danieltyukov/tue-bep/SIITME/Bump modeling.pptx

## TU/e huisstijl

Wednesday, 10 September 2025

- Timo Matray

- IC group, Department of Electrical Engineering

## Bump model

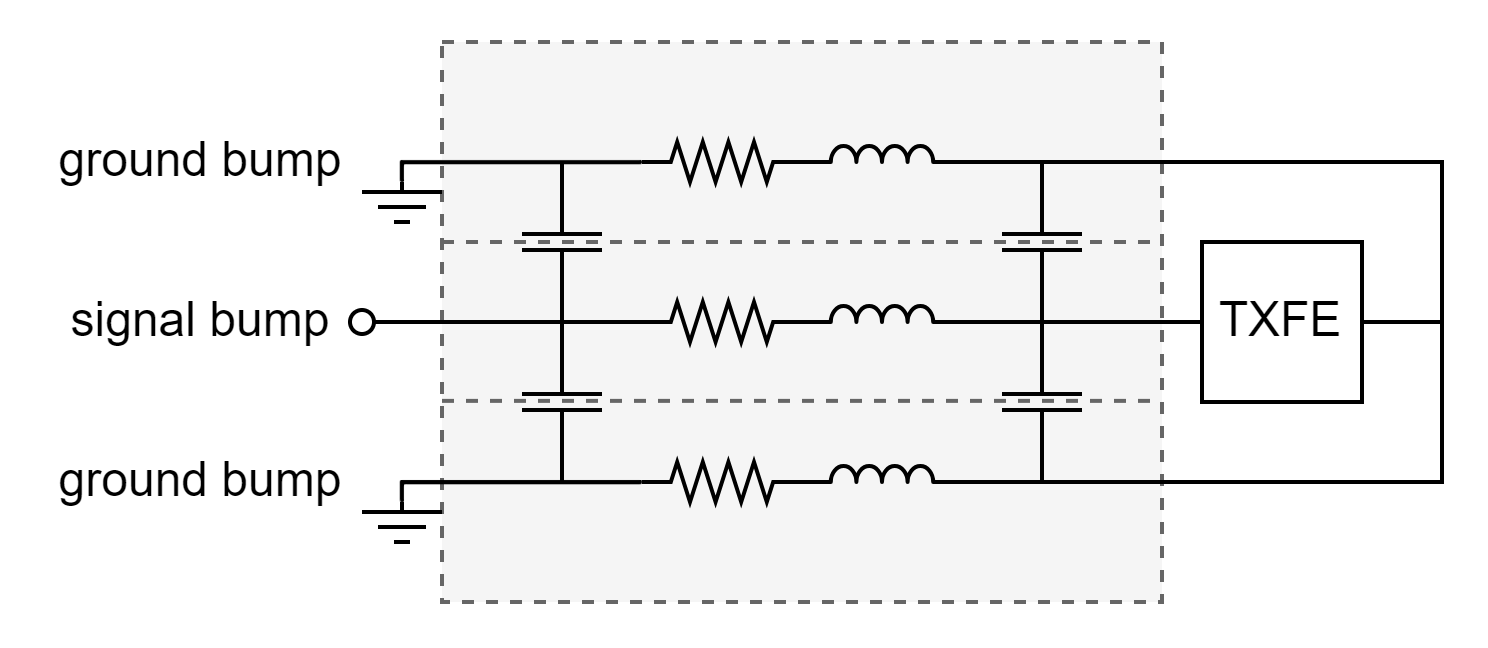
[picture p16: figure]

Timo Matray

## Slide 3

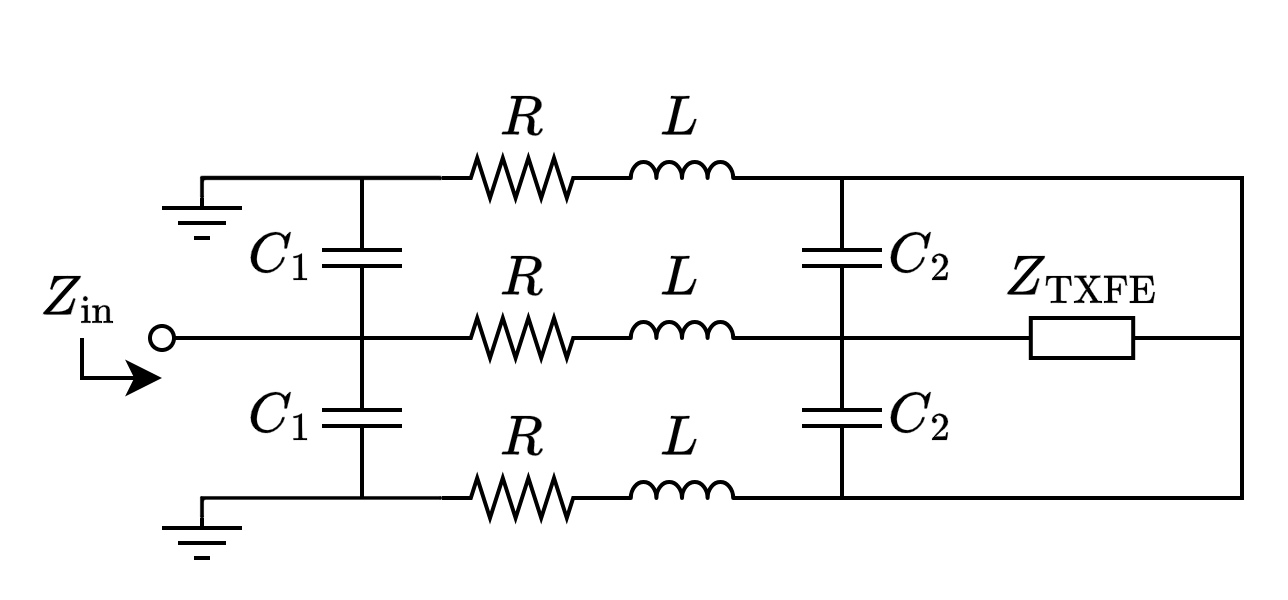
[picture p17: figure]

## Parallel ground paths

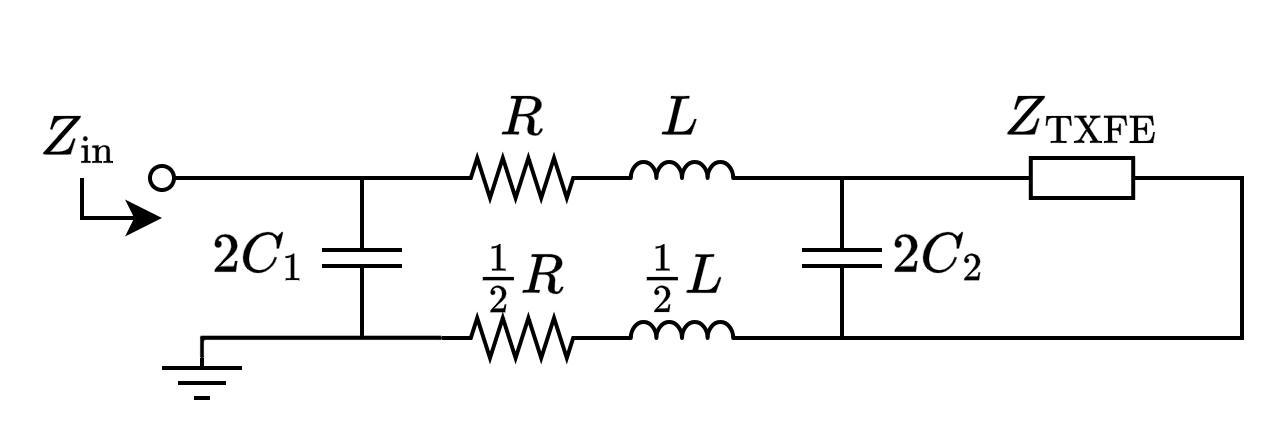
[picture p18: figure]

## RCL

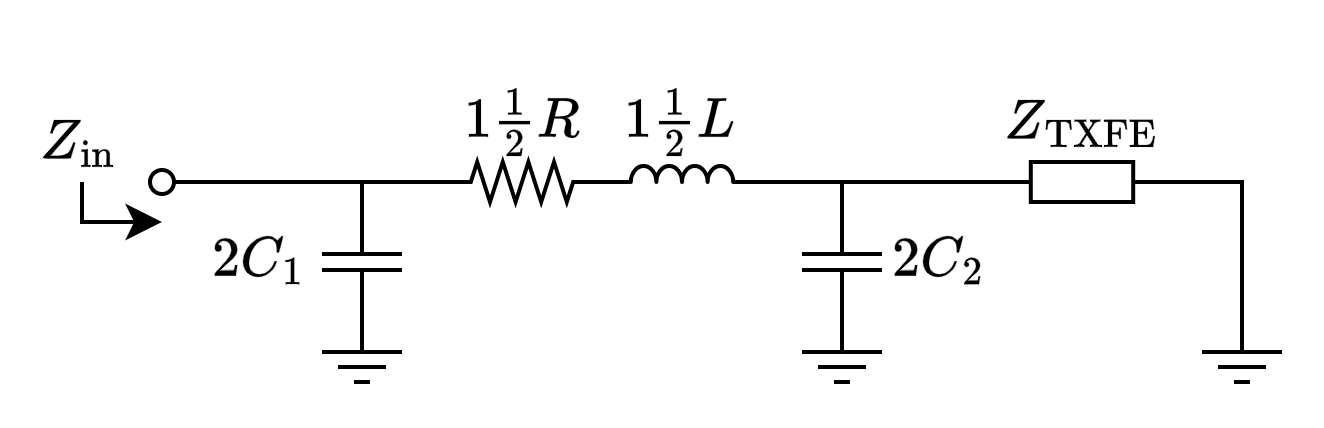
[picture p19: figure]

## Impedance fitting

## CRL

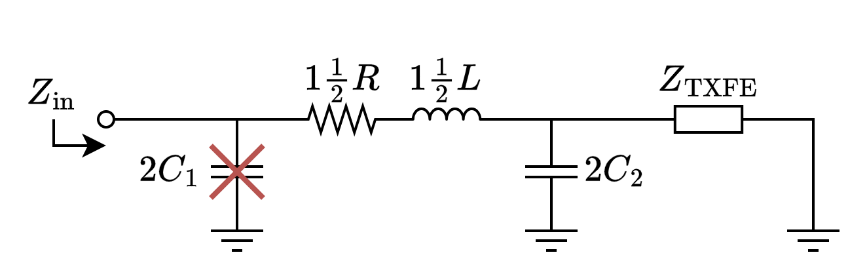
[picture p20: figure]

- R = 3.45 Ohm
- L = 218 nH
- C2 = 1.04 pF

## CRLC

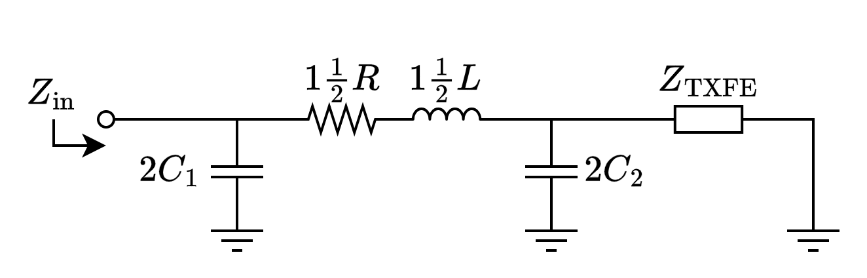
[picture p21: figure]

- C1 = 295 fF
- R = 3.45 Ohm
- L = 179 pH
- C2 = -1.22 pF

## CRL

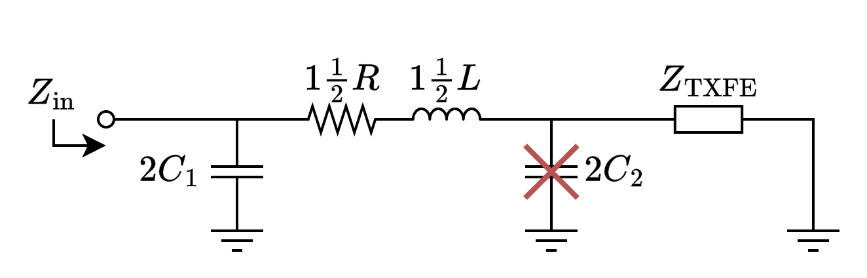
[picture p22: figure]

- C1 = 261 fF
- R = 3.45 Ohm
- L = 158 pH

## CRL (R not fixed)

- C1 = 185 fF
- R = 5.53 Ohm
- L = 201 pH

## CRL

- C1 = 261 fF
- R = 3.45 Ohm
- L = 158 pH
- ez,rel,max = 8.70 Ohm (30.6%)
- @ 6.02 GHz
- ez,abs,max = 10.3 Ohm (17.8%)
- @ 10.0 GHz
- ez,abs = 8.80 Ohm
- @ 6.23 GHz & 9.89 GHz

## S11 fitting

## CRL (R not fixed)

- S11

C1 = 185 fF
R = 5.16 Ohm
L = 211 pH

- Impedance

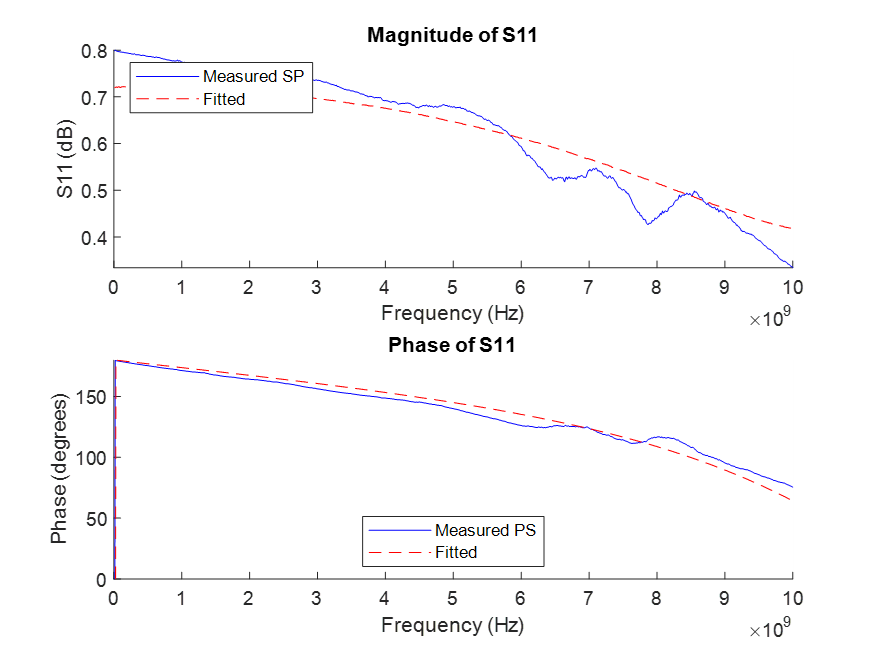
[picture p23: figure]
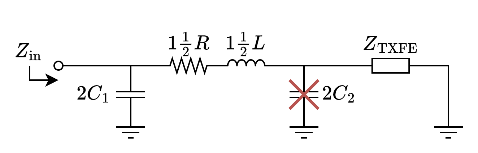
[picture p24: figure]

## CRL

- S11

C1 = 249 fF
R = 3.45 Ohm
L = 178 pH

- Impedance

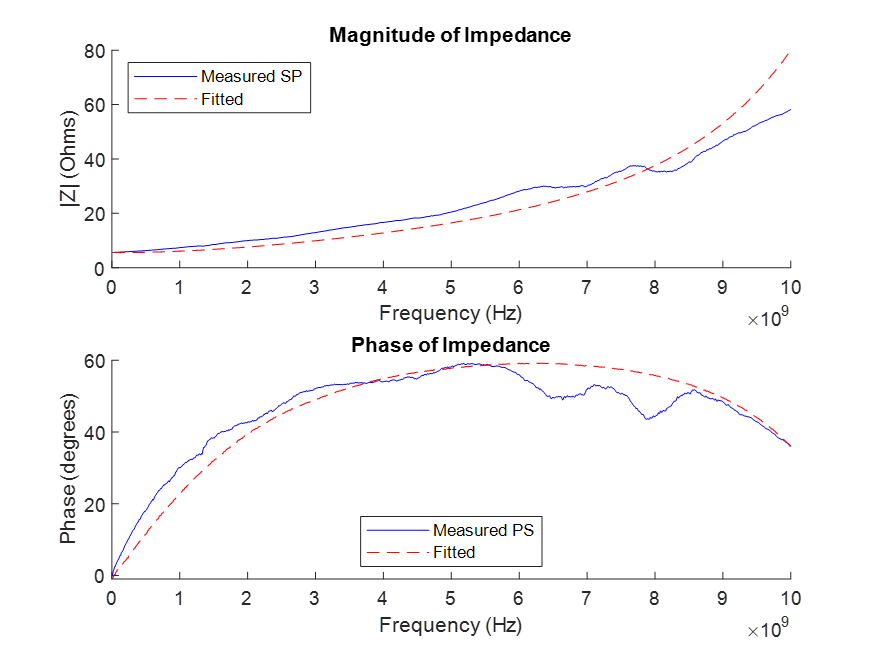
[picture p25: figure]
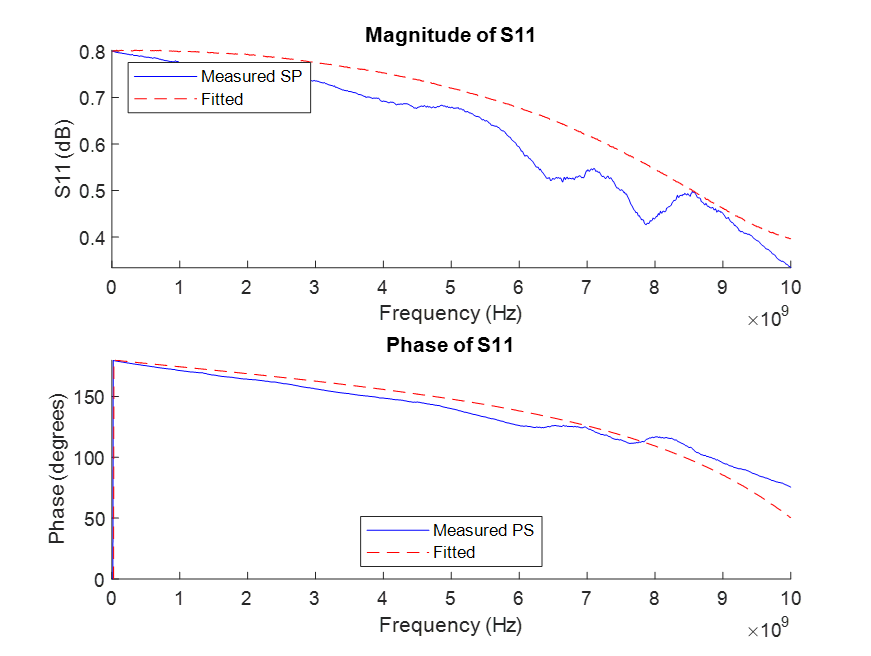
[picture p26: figure]

## CRL (optimized up to 5 GHz)

- S11

C1 = 249 fF
R = 3.45 Ohm
L = 178 pH

- Impedance
