danieltyukov/tue-bep/rf_die/Bonding Diagram RXFE 1 copy.pdf

# TXFE

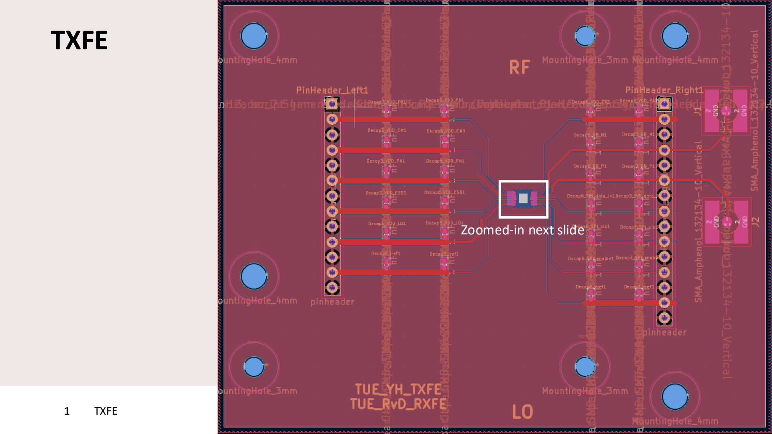
[picture p49: page 1]

1 TXFE

Zoomed-in next slide

# TXFE

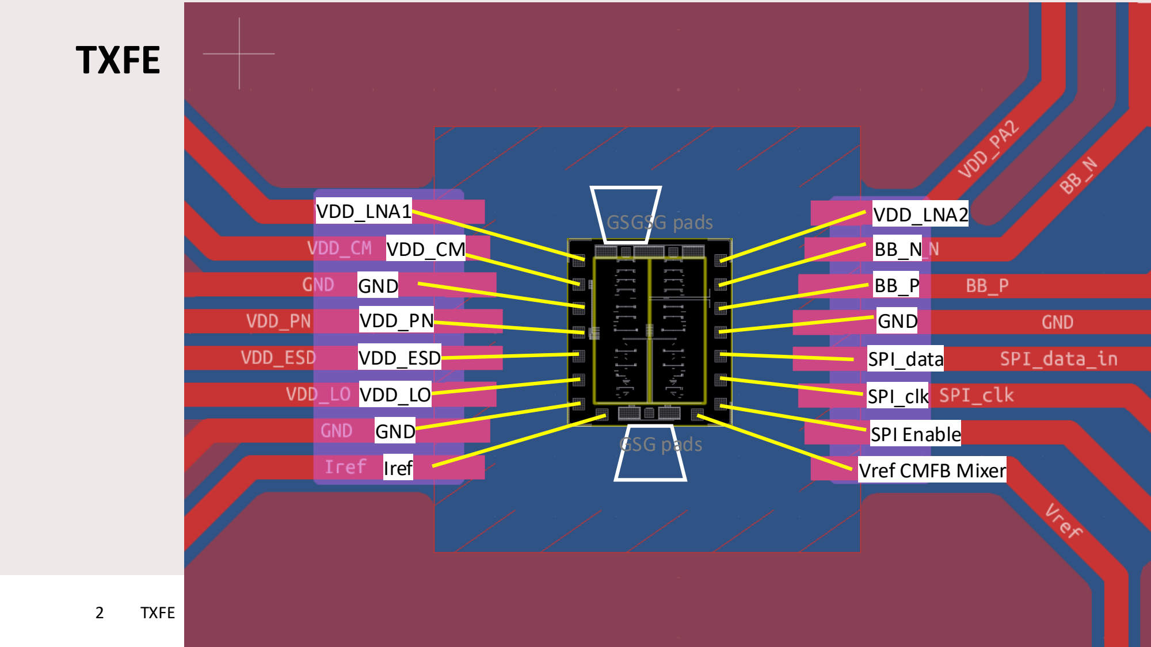
[picture p50: page 2]

TXFE

2

GSGSG pads

GSG pads
Vref CMFB Mixer

SPI Enable

SPI_clk

SPI_data

GND

BB_P

BB_N

VDD_LNA2

Iref

VDD_PN

VDD_LO

VDD_ESD

VDD_LNA1

GND

VDD_CM

GND
