danieltyukov/tue-bep/markdown_notes_and_files/litrature-preliminary/prior bep presentation.pdf

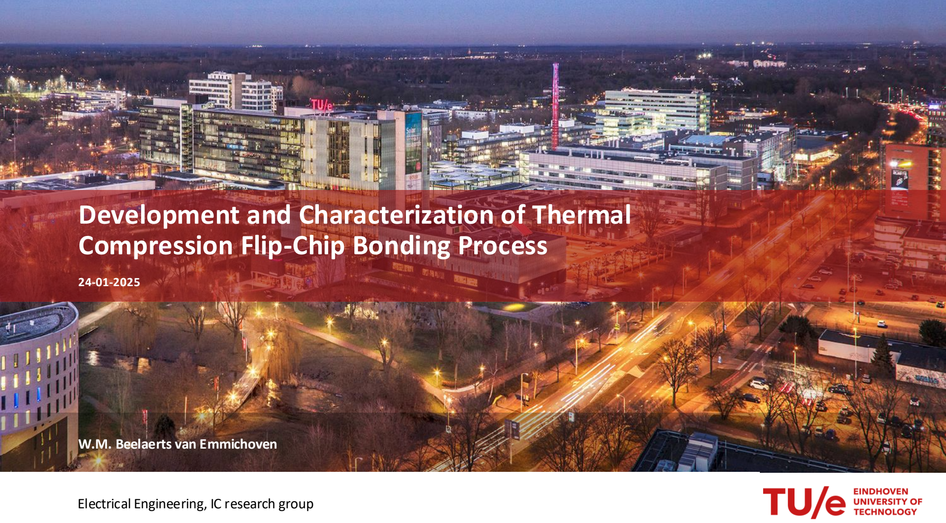
[picture p57: page 1]

# Development and Characterization of Thermal Compression Flip-Chip Bonding Process

24-01-2025

W.M. Beelaerts van Emmichoven

Electrical Engineering, IC research group

# Applications of the project

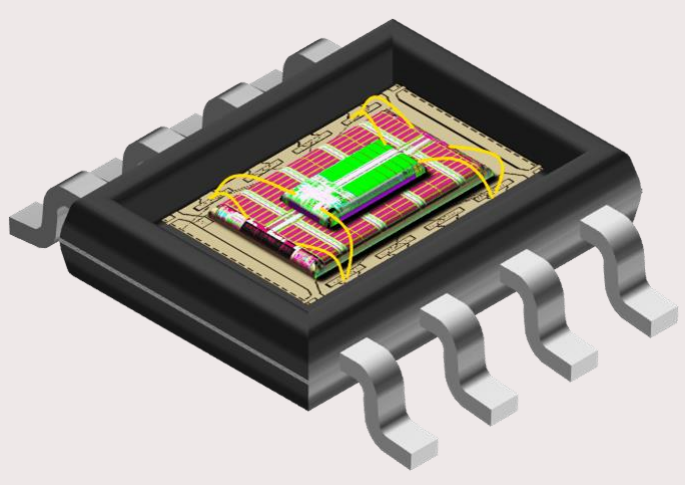
[picture p58: figure]

## - High-tech applications

## - Speed increasingly important - Hardware limitations

## - More and faster connections required

## - Packaging

2 Process Development and Characterization of Thermal Compression Flip-Chip Bonding

# Purpose of the project

## - Flip-Chip Technology vs Wire Bonding

### - More interconnections - Shorter interconnections - Lower propagation time

## - Process existence benefits TU/e projects requiring FCT

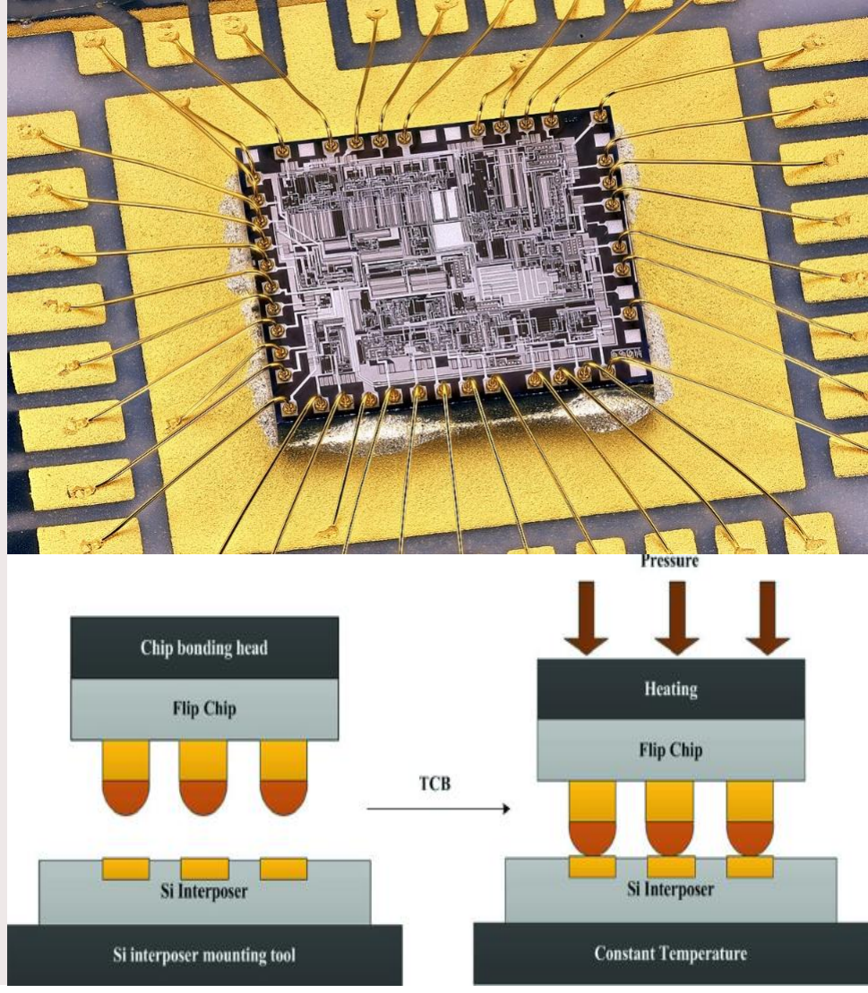
[picture p59: figure]

3 Process Development and Characterization of Thermal Compression Flip-Chip Bonding

# Project setup

## - Proposed process: 4 stages

### - Interposer design & production - Bump placement - Die placement - Testing

## - Developed for IC group

### - Cleanroom - Electronics lab

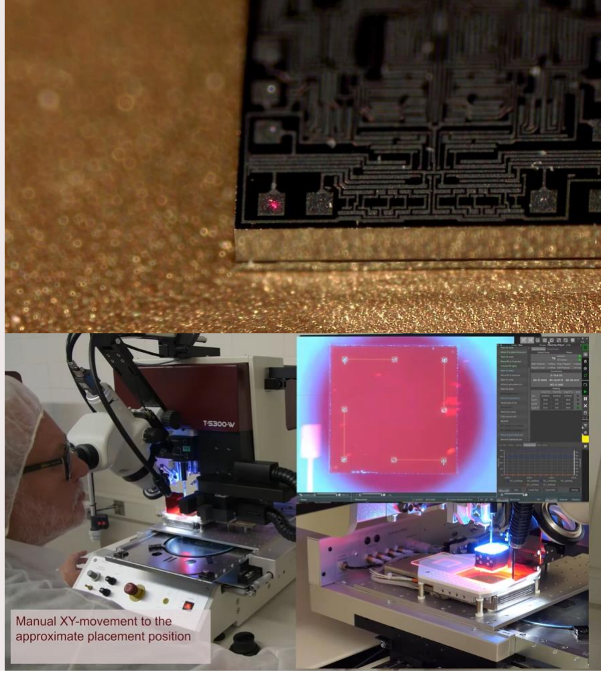
[picture p60: figure]

4 Process Development and Characterization of Thermal Compression Flip-Chip Bonding

# Process developments: Interposer Design

## - Glass interposer

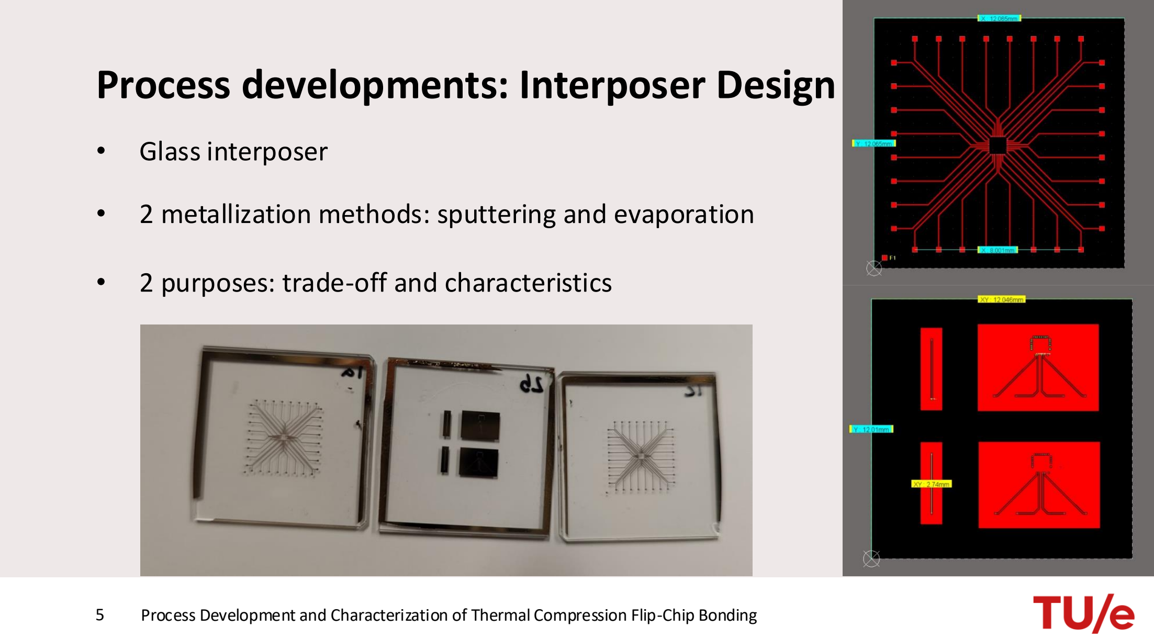
[picture p61: page 5]

## - 2 metallization methods: sputtering and evaporation

## - 2 purposes: trade-off and characteristics

5 Process Development and Characterization of Thermal Compression Flip-Chip Bonding

# Process developments: Interposer Characterization

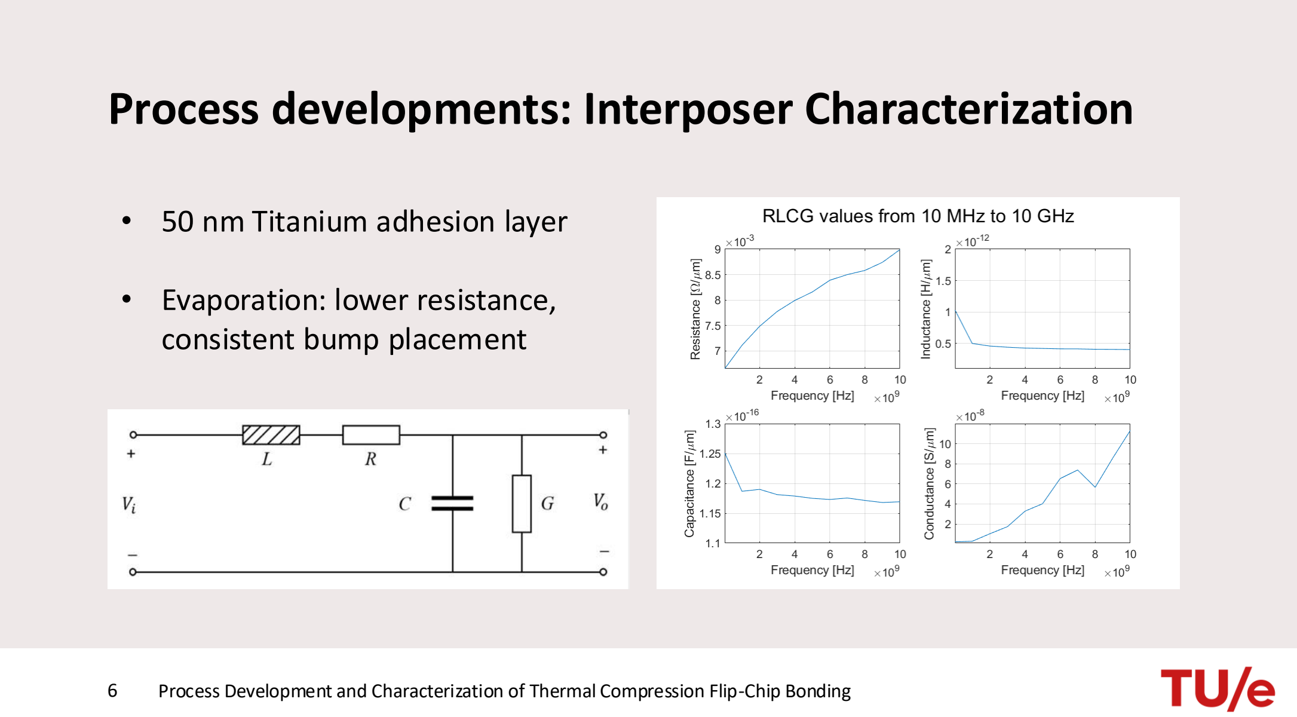
[picture p62: page 6]

6 Process Development and Characterization of Thermal Compression Flip-Chip Bonding

## - 50 nm Titanium adhesion layer

- Evaporation: lower resistance,

## consistent bump placement

# Process developments: Bumps

## - 25 vs 17 um gold wire

### - Good bump quality on small gold surface areas, but bad on large areas - Reliable process - Requires pad pitch > 90 um

## - Placement method: cursor as reference

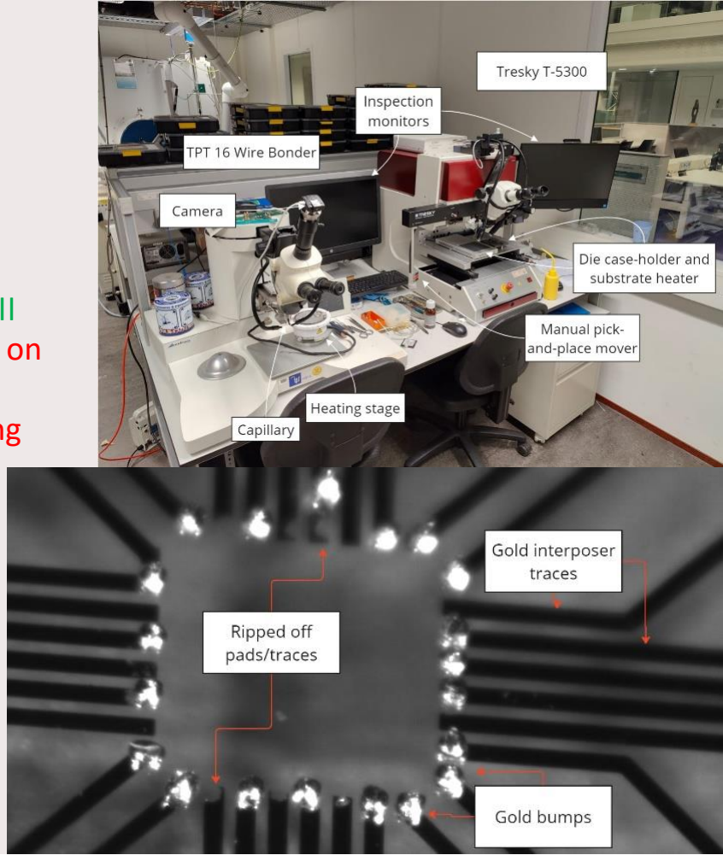
[picture p63: figure]

7 Process Development and Characterization of Thermal Compression Flip-Chip Bonding

### - Good bump quality on small gold surface areas, but bad on large areas - Unreliable process - clogging - 90 um pad pitch works

# Process developments: Dies

## - Heat profile, force and duration settings required

## - Semi-successful attempt

## - Weight distribution

## - Metal connections confirmed

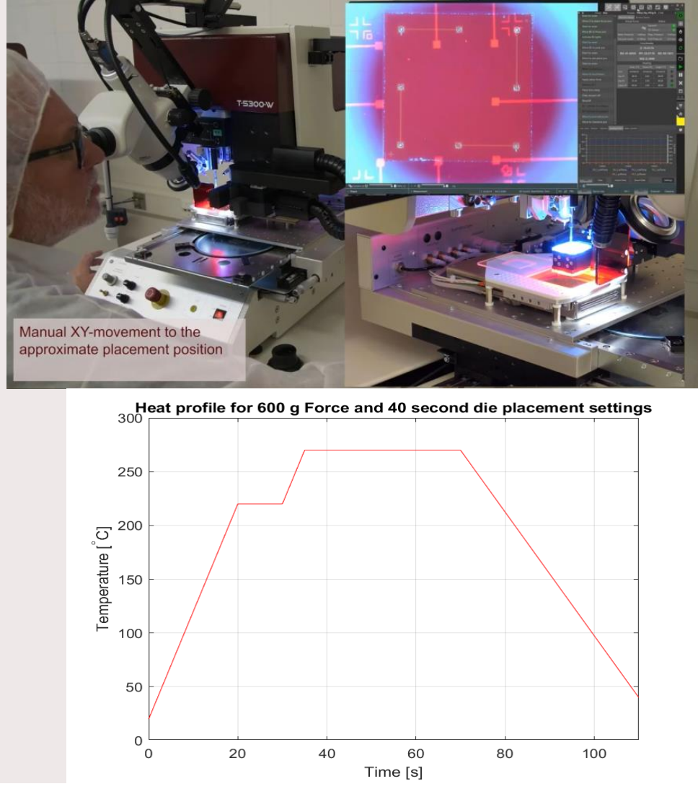
[picture p64: figure]

8 Process Development and Characterization of Thermal Compression Flip-Chip Bonding

# Final remarks

## - Cooperation with Accelonix recommended

## - Evaporation preferred production method

## - 25 um gold wire process most reliable, but requires pad pitch size > 90 um

## - Future research steps:

## 1. Improving and optimizing settings for bump and die placement 2. Investigate AC behaviour of tracks at frequencies >> 10 GHz 3. Exploring electrical characteristics of the bumps

9 Process Development and Characterization of Thermal Compression Flip-Chip Bonding

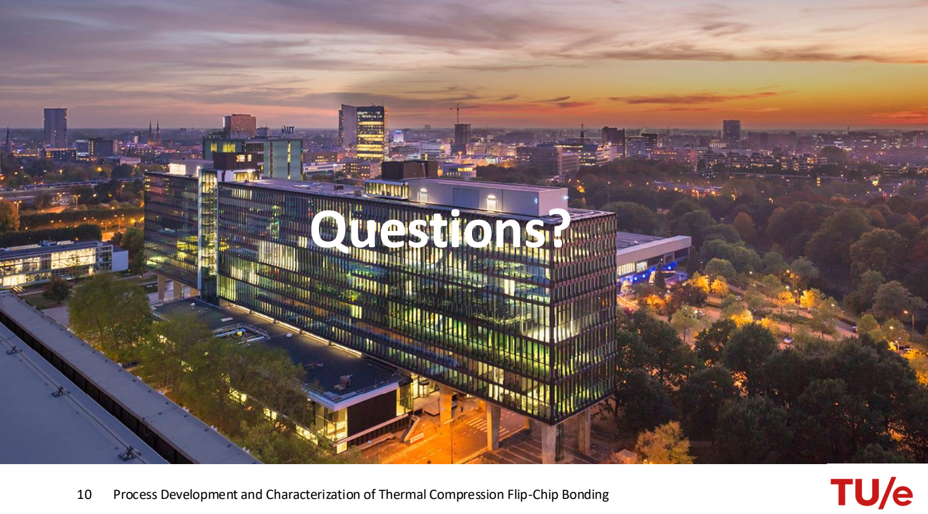
[picture p65: page 10]

10 Process Development and Characterization of Thermal Compression Flip-Chip Bonding

# Questions?
