danieltyukov/tue-bep/rf_die/interposer_estimates_v1.pdf

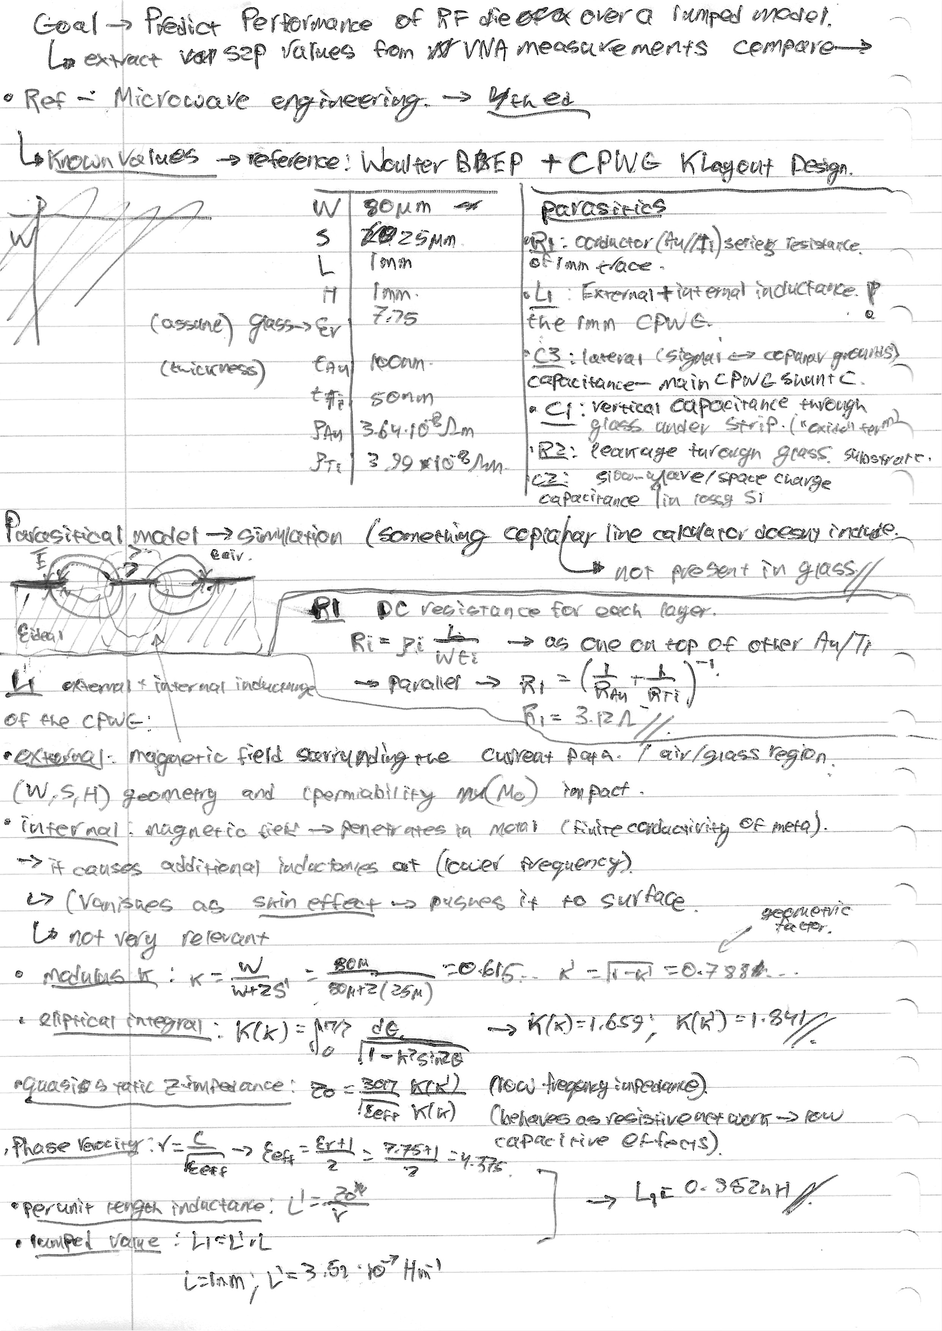
[picture p90: page 1]
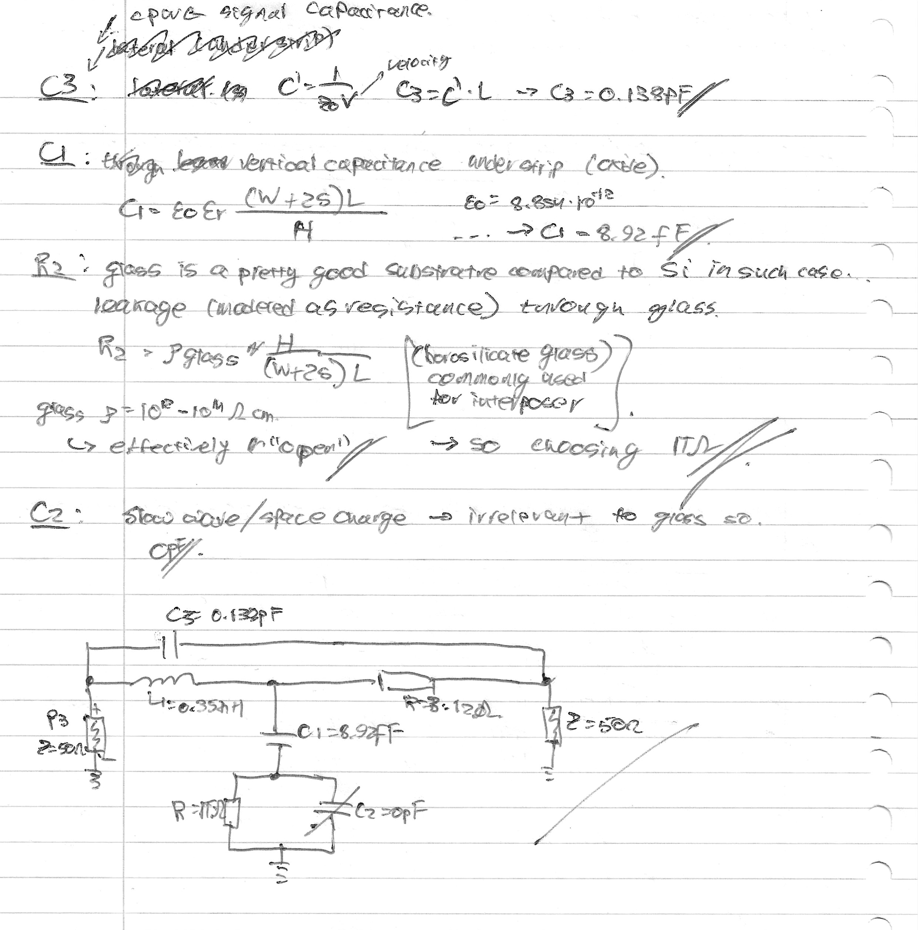
[picture p91: page 2]
