danieltyukov/tue-bep/SIITME/SIITME_2025_v1/figures/flipchip2.pdf

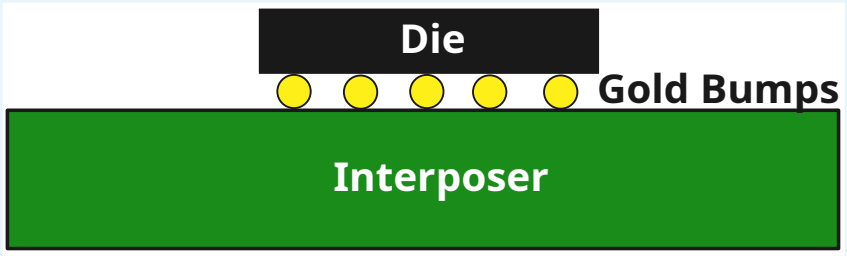
[picture p92: figure]
Interposer; Die; Gold Bumps
