danieltyukov/tue-bep/amplifier_die/inverted-tgf-amplifier-mask.png

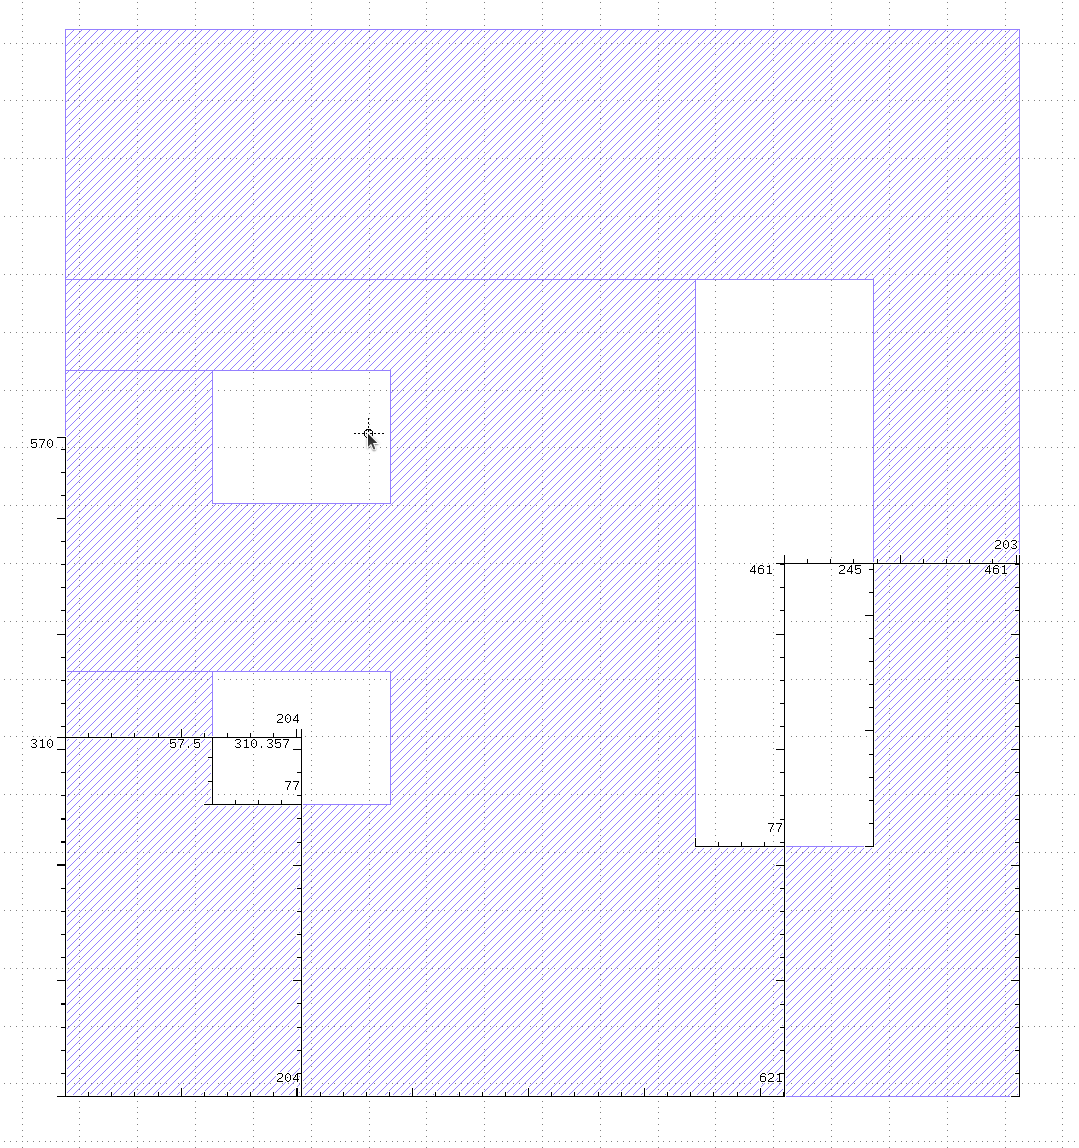
amplifier_die/inverted-tgf-amplifier-mask.png
