danieltyukov/tue-bep/amplifier_die/smd-0603-0402.jpg

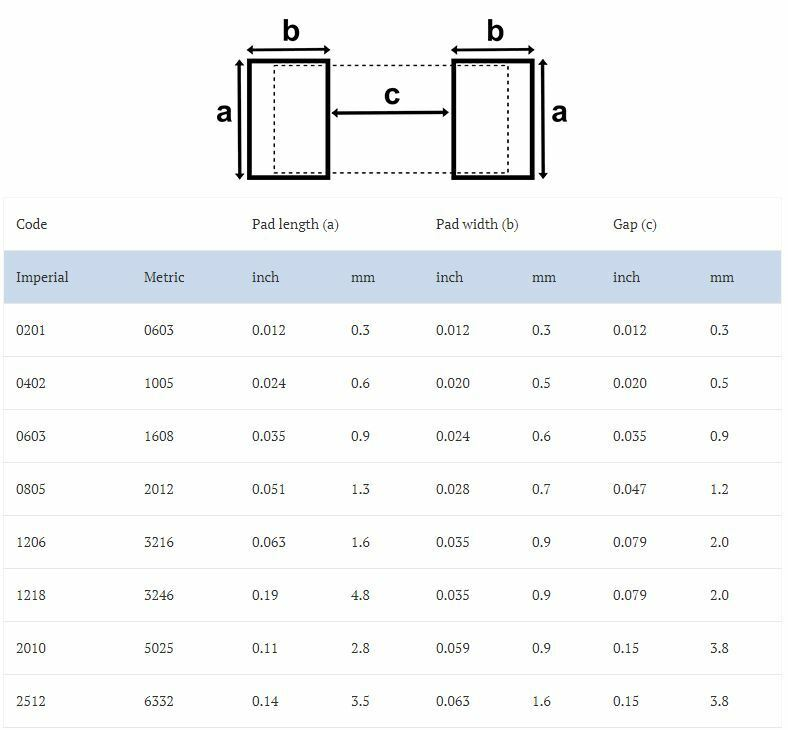
amplifier_die/smd-0603-0402.jpg
