danieltyukov/tue-bep/final_pics_for_paper/tgf_2023_2_02_cw_model_circuit_qucs.png

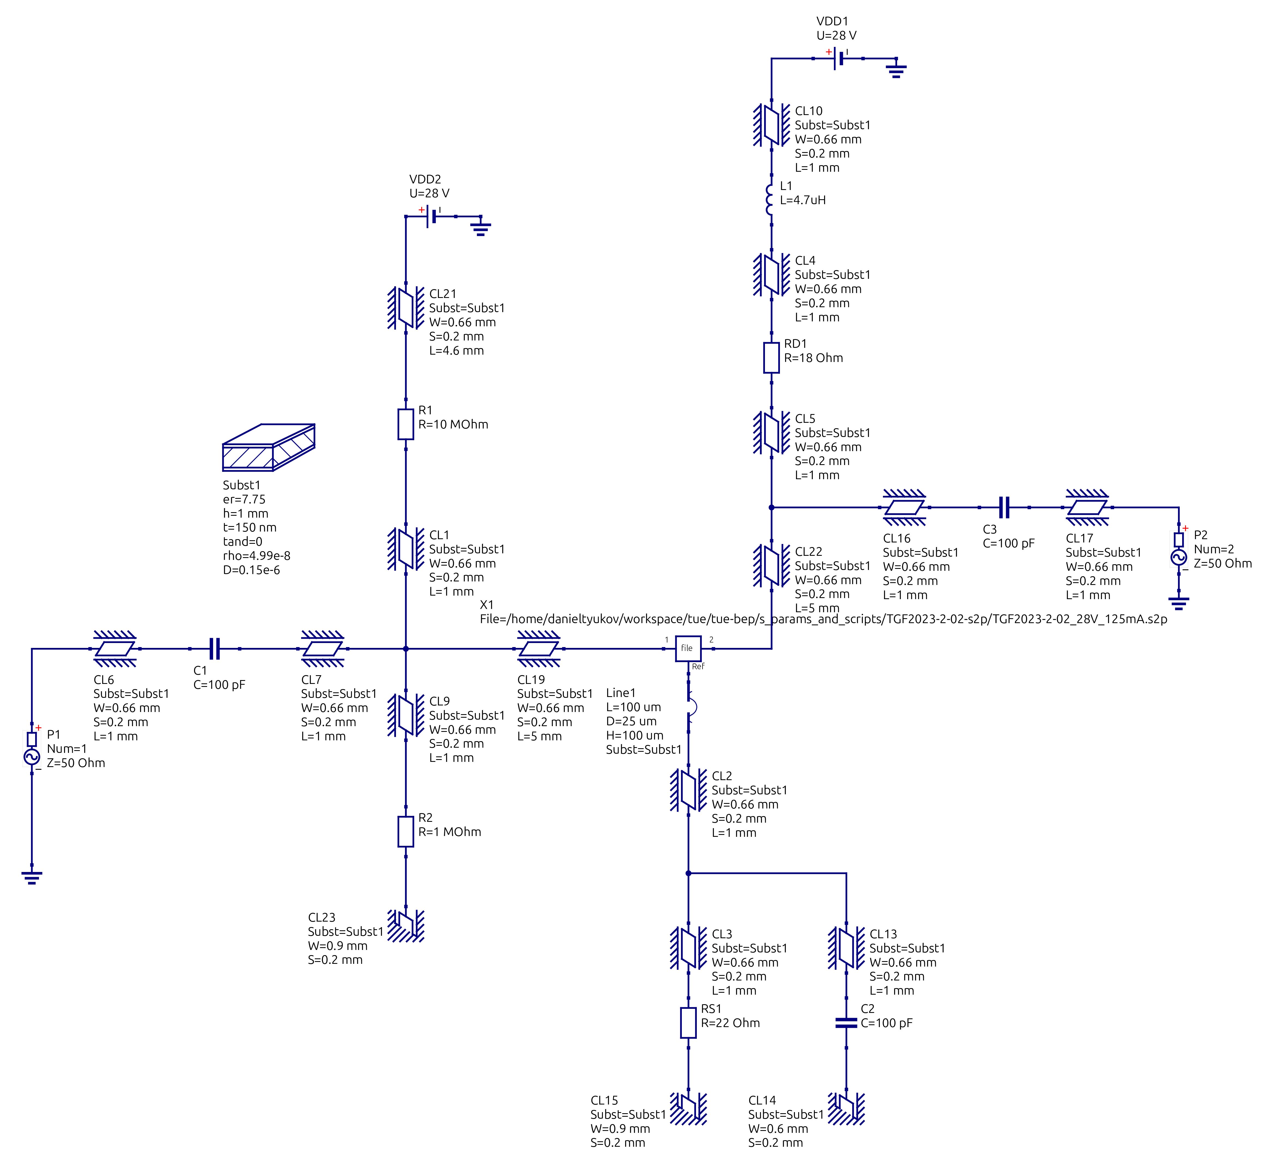
final_pics_for_paper/tgf_2023_2_02_cw_model_circuit_qucs.png
