danieltyukov/tue-bep/rf_die/dbS33.png

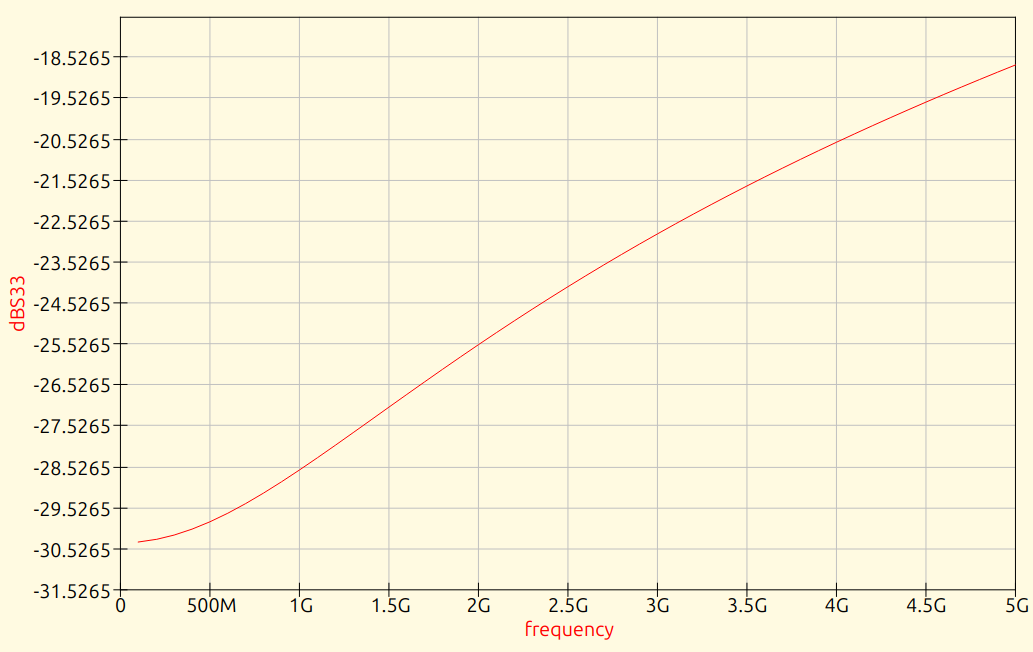
rf_die/dbS33.png
