danieltyukov/tue-bep/rf_die/dbS43.png

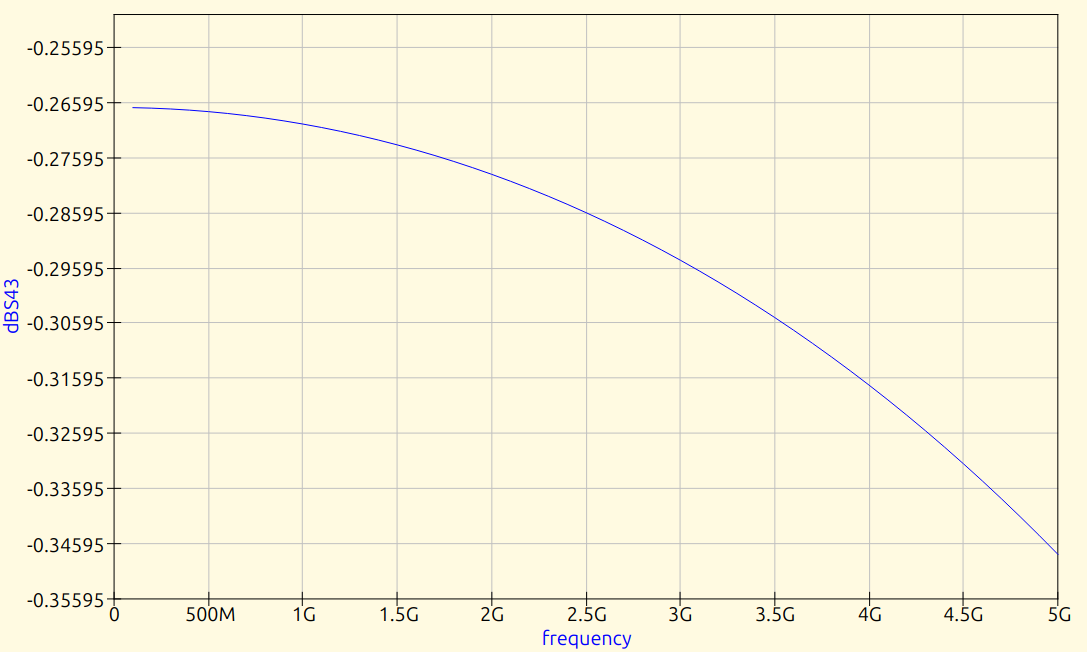
rf_die/dbS43.png
