danieltyukov/tue-bep/rf_die/qucs_cwg_calcs/external_pads_150um.png

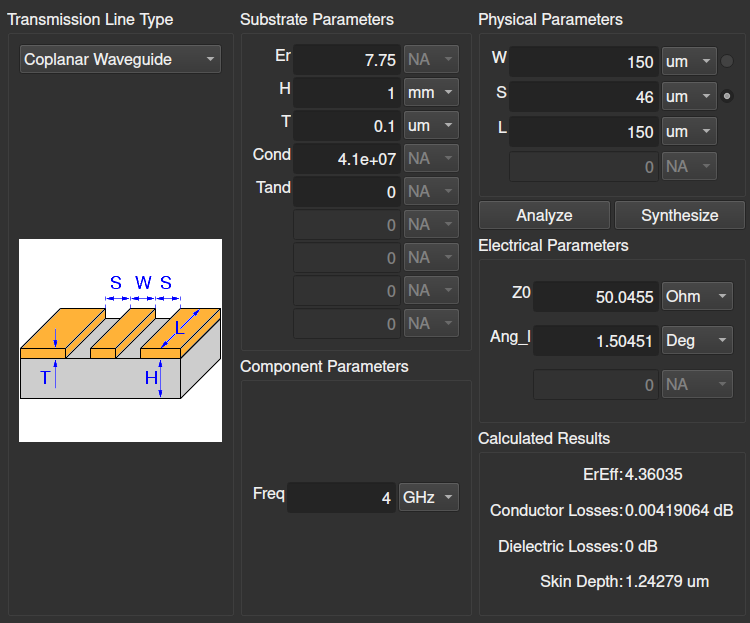
rf_die/qucs_cwg_calcs/external_pads_150um.png
