danieltyukov/tue-bep/rf_die/qucs_cwg_calcs/gsg/traces_60um_unrealistic.png

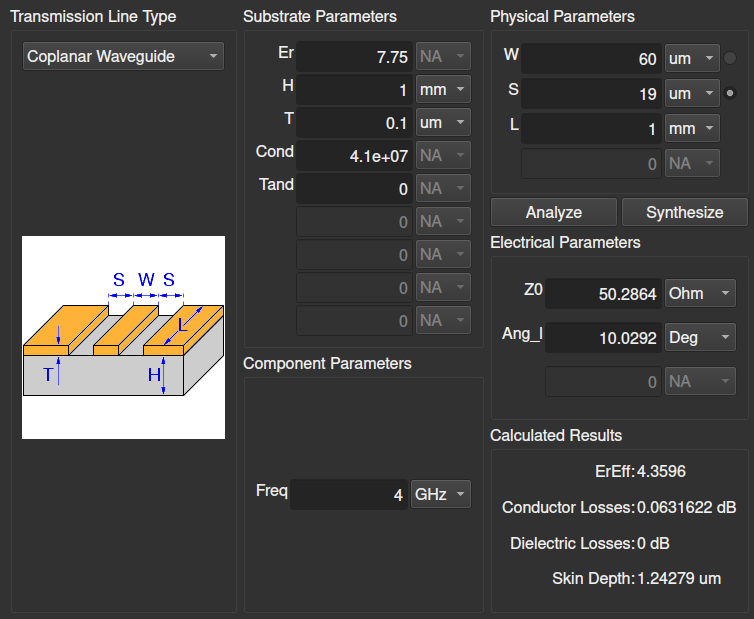
rf_die/qucs_cwg_calcs/gsg/traces_60um_unrealistic.png
