danieltyukov/tue-bep/rf_die/rf chip dimensions.png

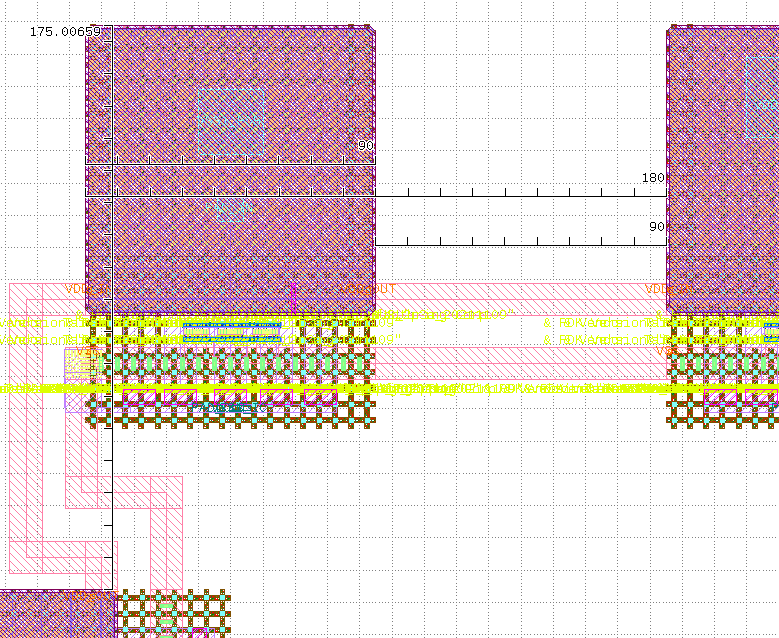
rf_die/rf chip dimensions.png
