danieltyukov/tue-bep/SIITME/SIITME_2025_v1/figures/ball width.png

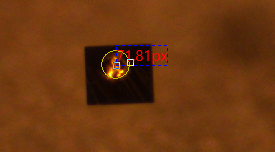
SIITME/SIITME_2025_v1/figures/ball width.png
