danieltyukov/tue-bep/SIITME/SIITME_2025_v1/figures/die.jpeg

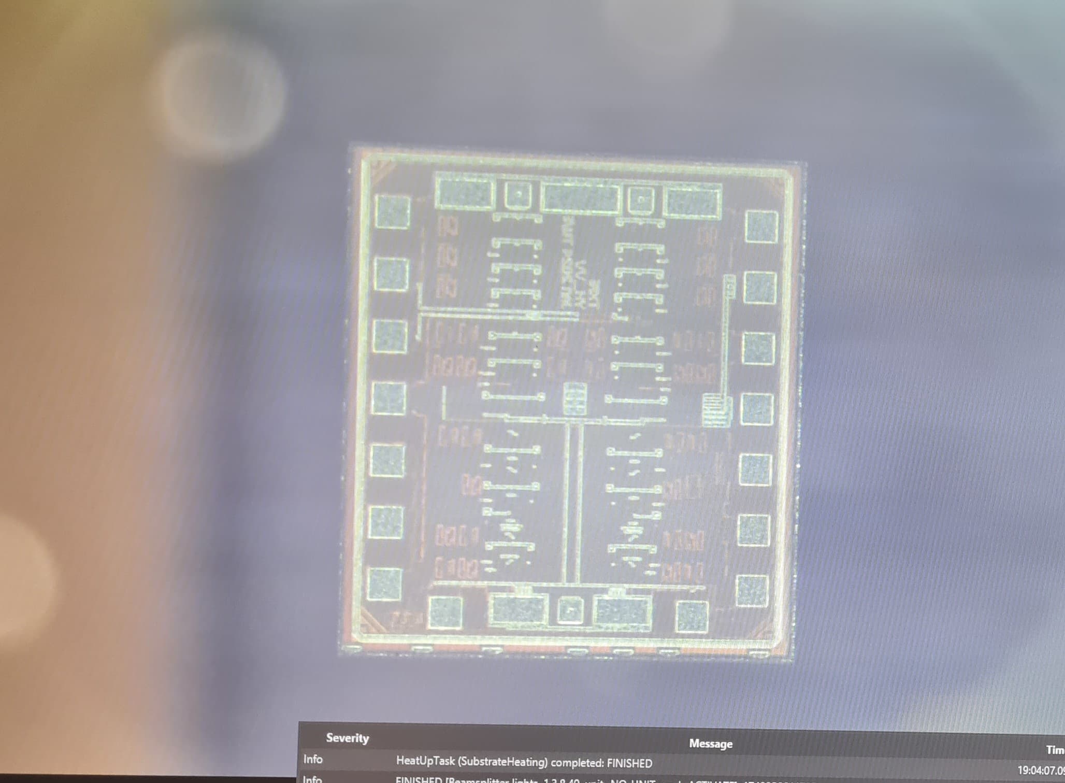
SIITME/SIITME_2025_v1/figures/die.jpeg
