danieltyukov/tue-bep/SIITME/SIITME_2025_v1/figures/flip_chipped_fake_die.jpeg

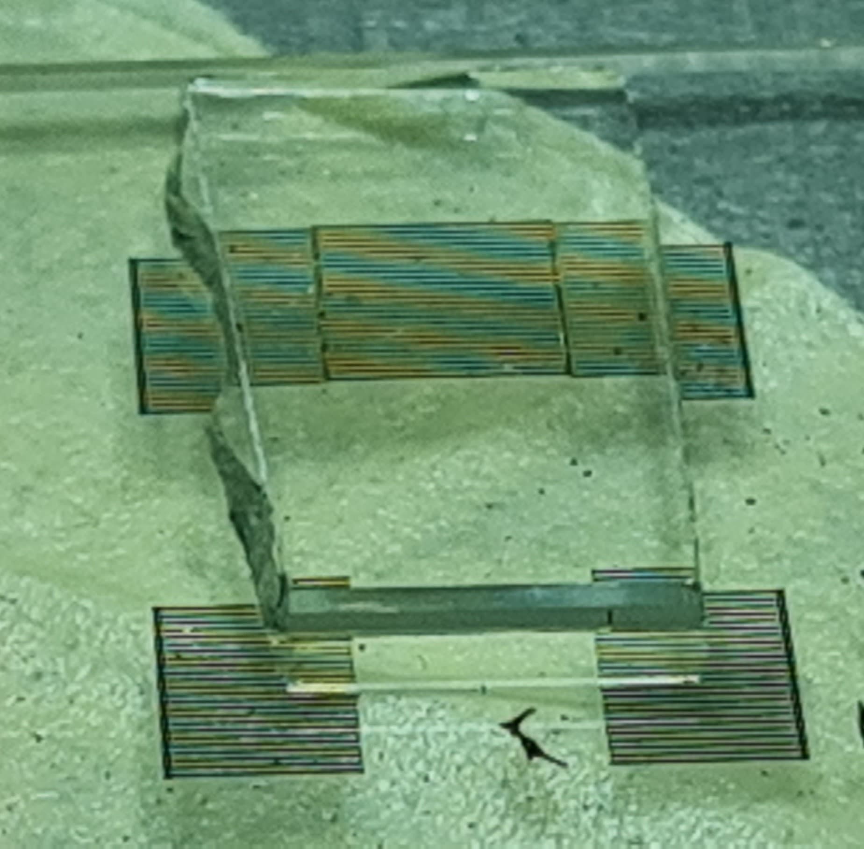
SIITME/SIITME_2025_v1/figures/flip_chipped_fake_die.jpeg
