danieltyukov/tue-bep/SIITME/SIITME_2025_v1/figures/goldbump_thermalprofile1.jpeg

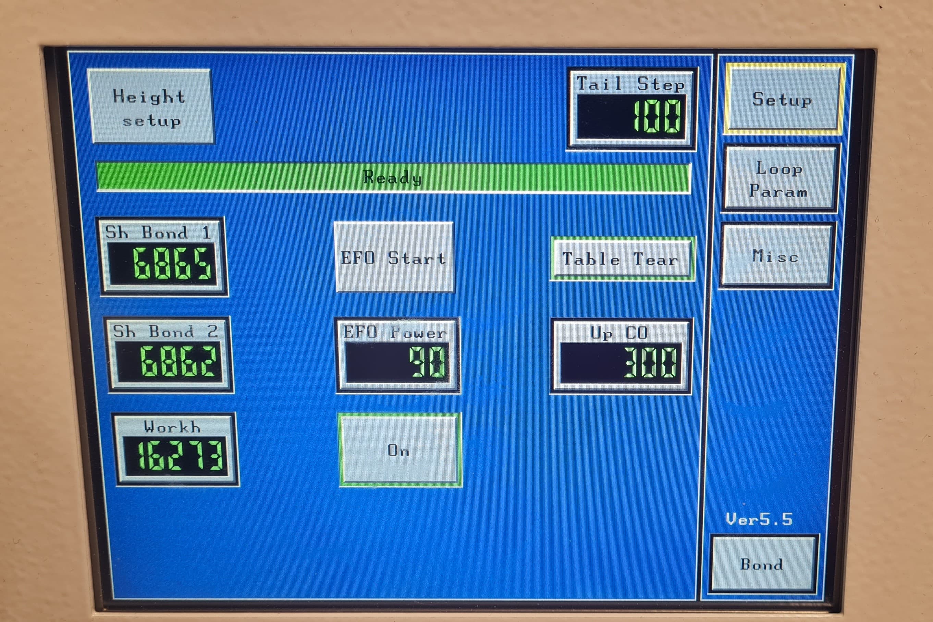
SIITME/SIITME_2025_v1/figures/goldbump_thermalprofile1.jpeg
