danieltyukov/tue-bep/SIITME/SIITME_2025_v1/figures/goldbump_thermalprofile2.jpeg

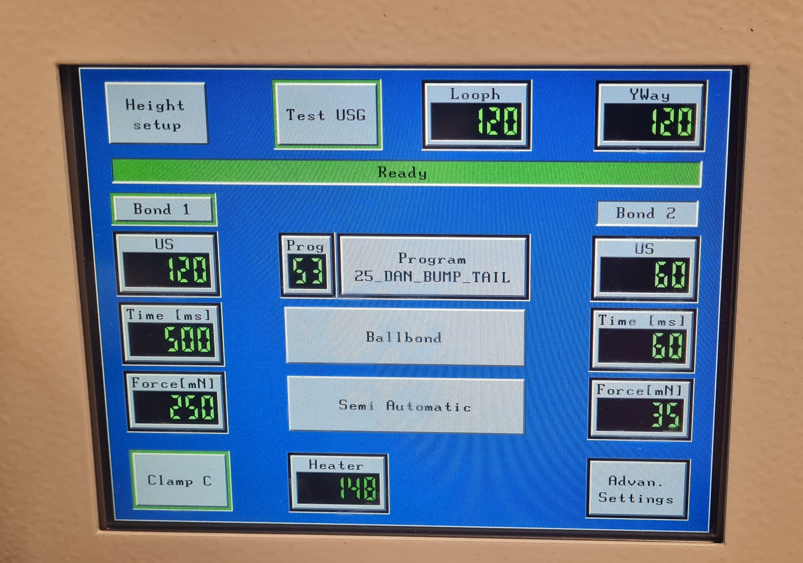
SIITME/SIITME_2025_v1/figures/goldbump_thermalprofile2.jpeg
