danieltyukov/tue-bep/SIITME/SIITME_2025_v1/figures/goldbumps.png

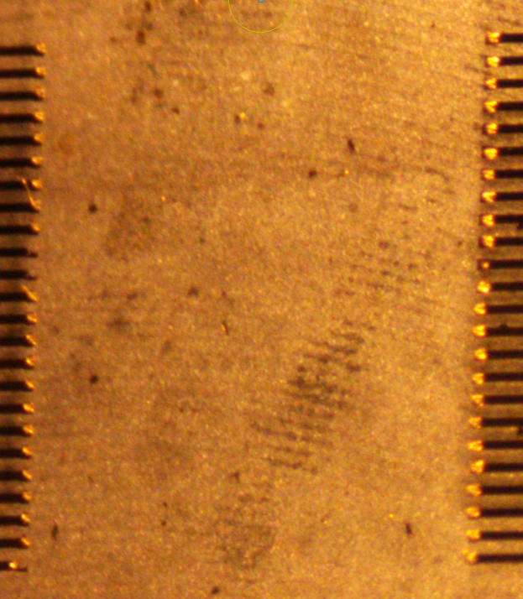
SIITME/SIITME_2025_v1/figures/goldbumps.png
