danieltyukov/tue-bep/SIITME/SIITME_2025_v1/figures/interposer_gold_bumped.jpeg

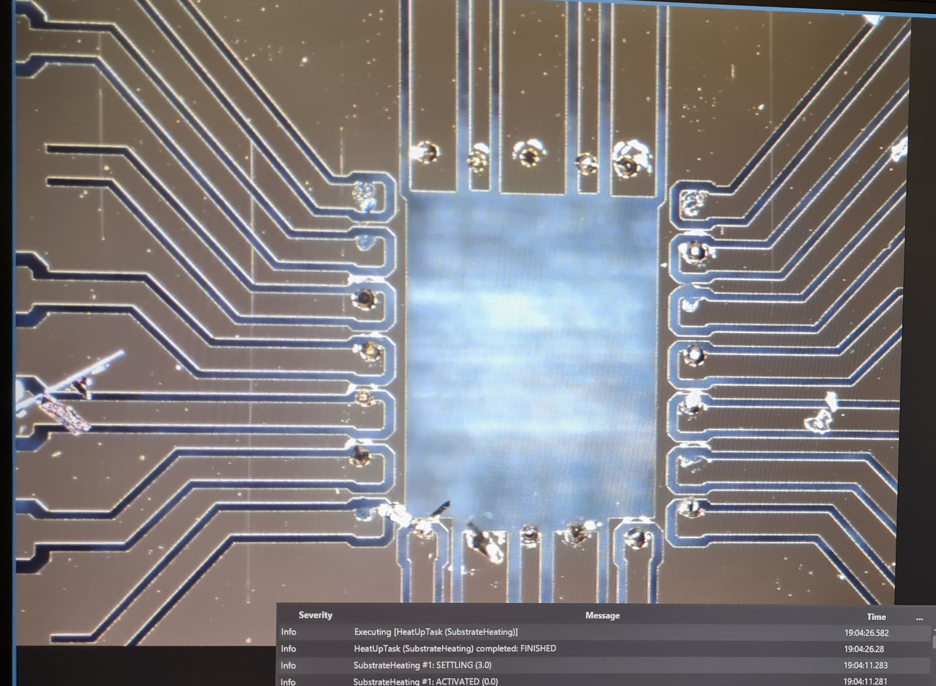
SIITME/SIITME_2025_v1/figures/interposer_gold_bumped.jpeg
