danieltyukov/tue-bep/SIITME/SIITME_2025_v1/figures/MATLABfit.png

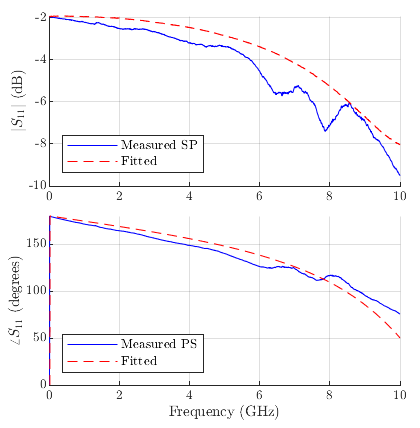
SIITME/SIITME_2025_v1/figures/MATLABfit.png
