danieltyukov/tue-bep/markdown_notes_and_files/litrature-preliminary/flip chip assembly for sub millimeter wave amplifier mmic.pdf

## Flip Chip Assembly for Sub-millimeter Wave Amplifier MMIC on Polyimide Substrate

Y oichi Kawano, Hiroshi Matsumura, Shoichi Shiba, Masaru Sato, Toshihide Suzuki, Yasuhiro Nakasha, Tsuyoshi Takahashi, Kozo Makiyama, and Naoki Hara

FUJITSU LIMITED, ATSUGI, KANAGA WA 243-0197, JAPAN

Abstract - The sub-millimeter wave amplifier MMIC with flip-chip mounting on polyimide substrate has been realized. The thickness of the substrate and the pitch of GND vias are designed to suppress the air radiation from the slot pattern in the substrate. The test results of the micro-strip line formed on the poly imide substrate shows that the design is applicable to the assembly operated up to 320 GHz. The InP HEMT amplifier MMIC with the assembling technique achieved the operation in 240-260 GHz frequency band with the gain of20 dB.

Index Terms -lnP, HEMT, sub-millimeter, flip chip.

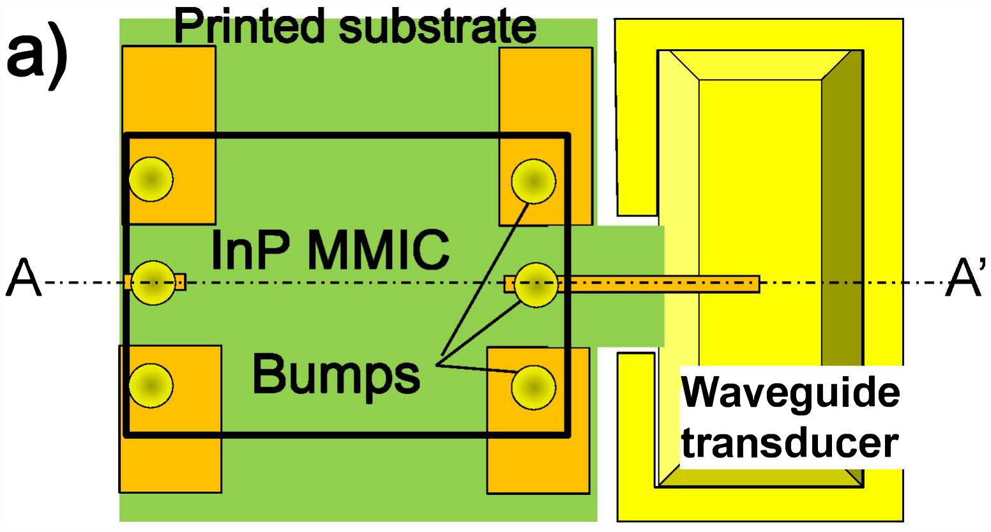
[picture p109: figure]
Waveguide transducer

I. INTRODUCTION
The broad atmospheric window between 200 and 300 GHz
[1] is attractive for radio astronomy, imaging sensors, and multi-IO Gigabit wireless communications due to the high
available | absolute | bandwidths. | Sub-millimeter-wave
monolithic integrated circuits (MMICs) based on InP or GaAs metamorphic high electron mobility transistor (HEMT) will enhance the capability of these applications [2-7]. In sub-millimeter-wave band, not only MMIC but also chip assembly should be carefully designed. Because the wave length of signal becomes close to 100 /lm, the design to bond the chip and the substrate affects on RF performances significantly. Therefore, a conventional face-up mounting of chip or a wiring technique cannot be used in this frequency band.
In this paper, we report the feasibility of flip chip assembly in sub-millimeter wave band. A suitable GND pattern for chip mounting board is discussed based on simulation and measurement. The measurement results of the flip chip mounting MMIC amplifier are presented as well.

II. FLIP CHIP ASSEMBLY
A. Chip assembly methods
First, the module image for sub-millimeter wave application we considered is shown in Fig.I. Figure.la indicates the top view of the module image and its cross-sectional view along line (A-A') comprised of InP MMIC, printed substrate and micro-strip line (MSL) waveguide transducer. In order to achieve high gain, the use of a metal horn antenna is considered. The MMIC is mounted on the printed substrate. The interface between the MSL and the antenna can be realized by the conventional back-short structure shown in the figure. There are two types of the chip mounting on the board in sub-millimeter wave band. First, the face-up mounting using through-substrate via as shown in Fig. 1 b [2,3]. With this type, the substrate thickness of the InP chip should be thinner than 50 /lm to avoid undesired millimeter wave propagation in the substrate. As a result, the mechanical strength of the InP chip decreases, and the yield ratio of fabrication process goes down. Therefore, we choose the flip chip mounting, as shown in Fig.lc. A micro-strip line structure is employed for interconnection in the circuit. Two metal layers are assigned for signal and GND. The GND metal layer shields the electrical field spread to the InP substrate. Au ball bumps are

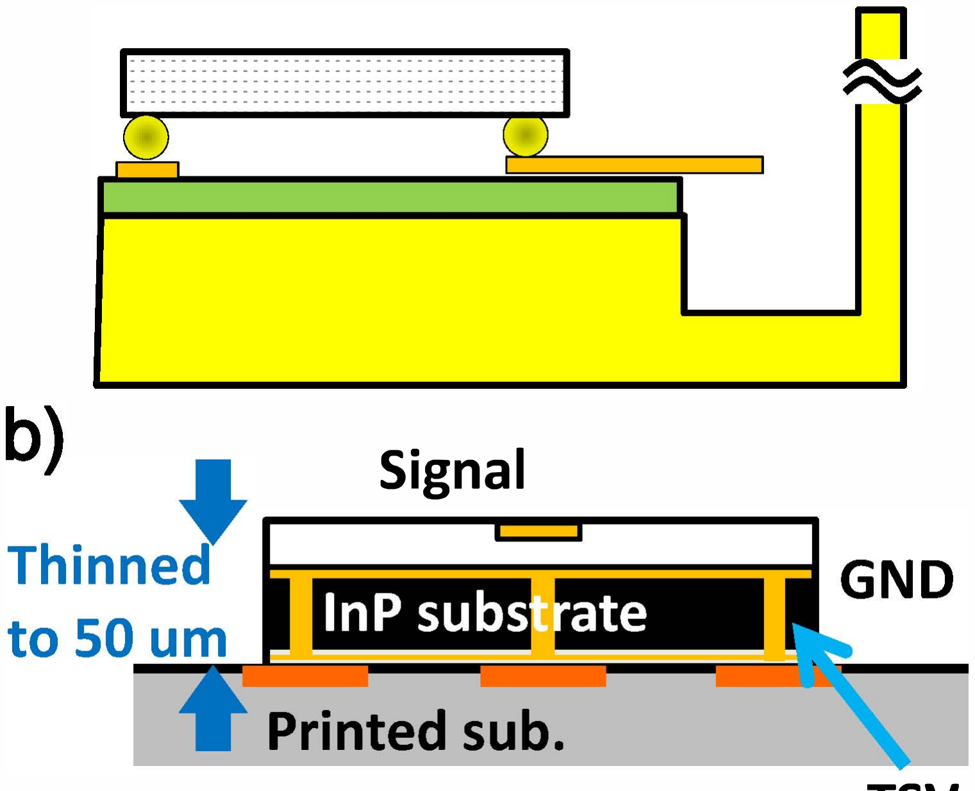
[picture p110: figure]
Signal

c)

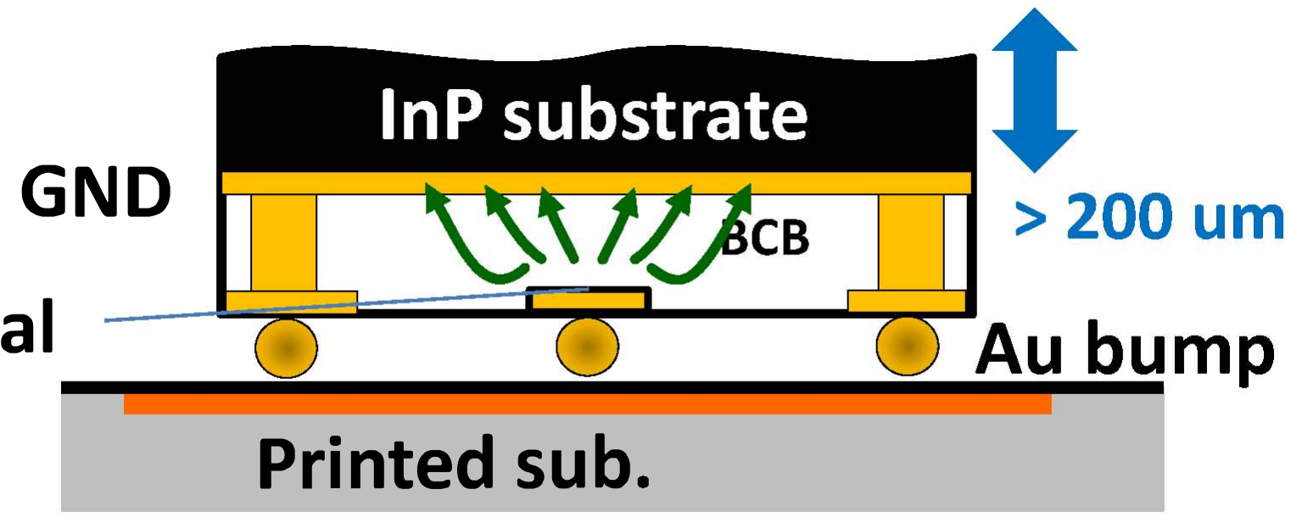
[picture p111: figure]
GND; Printed sub.

Signal

TSV

Fig. 1 a) Top and cross-sectional view of module image, b) face-up mounting, and c) flip chip mounting.

Authorized licensed use limited to: Eindhoven University of Technology. Downloaded on September 05,2024 at 10:14:06 UTC from IEEE Xplore. Restrictions apply. 978·1-4799-3869-8/14/$31.00 ®2014 IEEE used to bond a chip and a printed substrate. The insulator film on the chip is a few um thick, and this is sufficiently thin compared with the distance between the chip and the printed substrate (typically 50 f!m). Therefore the most electrical field concentrates in the chip. The influence of the electrical coupling between the chip and the substrate can be negligible. Table 1 shows the comparison of a dielectric constant, a tan-c>, a loss, and design rules for a quartz substrate and a polyimide substrate. L means the distance between metal edge and through via, and D means the pitch of vias. The quartz is desirable for the substrate in terms of loss. However, the design rule for vias is not fine compared with that of the polyimide. Since the quarter wavelength (1../4) of the signal in the substrate becomes less than 200 f!m at sub-millimeter band, the influence of the length of L and D should be considered for designing the substrate. We discuss the design in the next section.

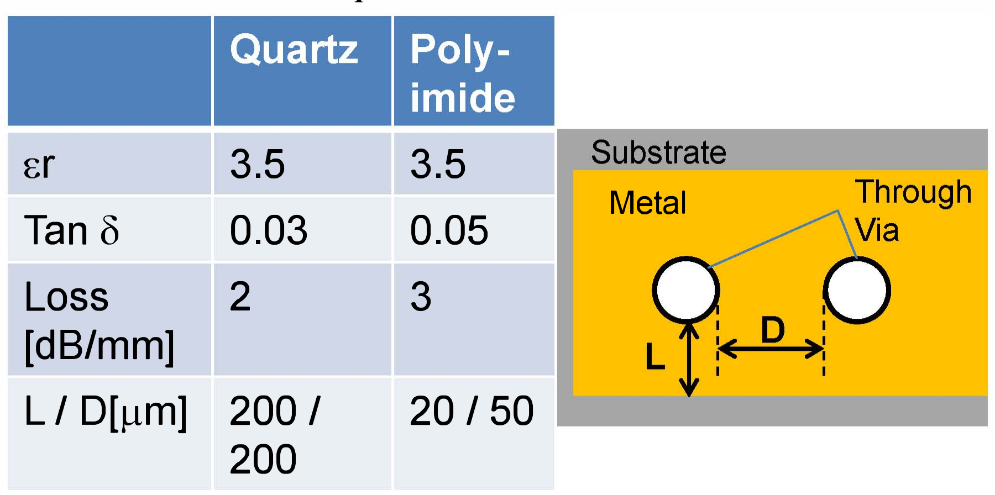
[picture p112: figure]
Tan 8; Metal; Loss; LI D[Jlm] 2001

Table 1 Comparison of low loss substrates

B. Feasibility of flip chip on polyimide substrate
a) b)

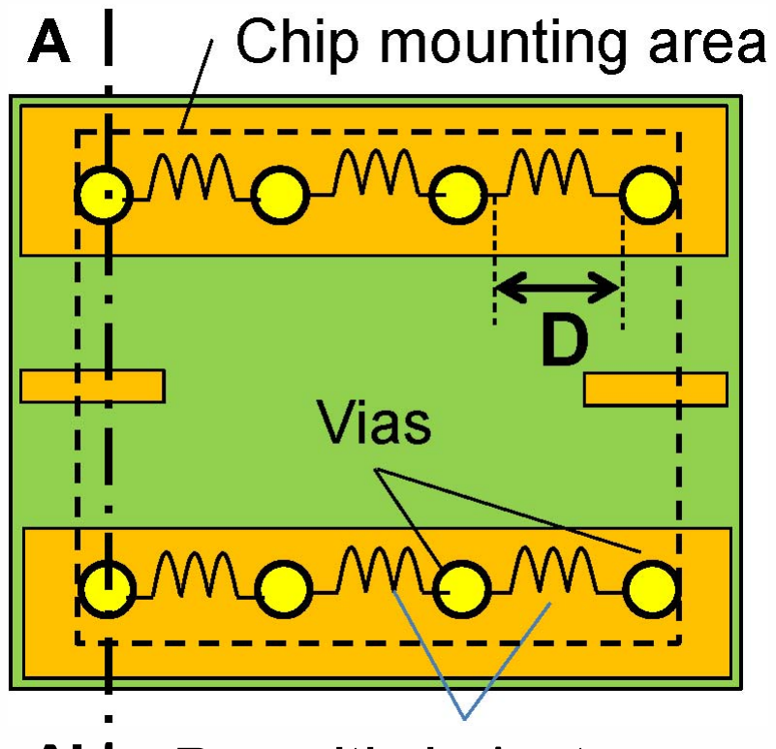
[picture p113: figure]

A' I Parasitic inductances

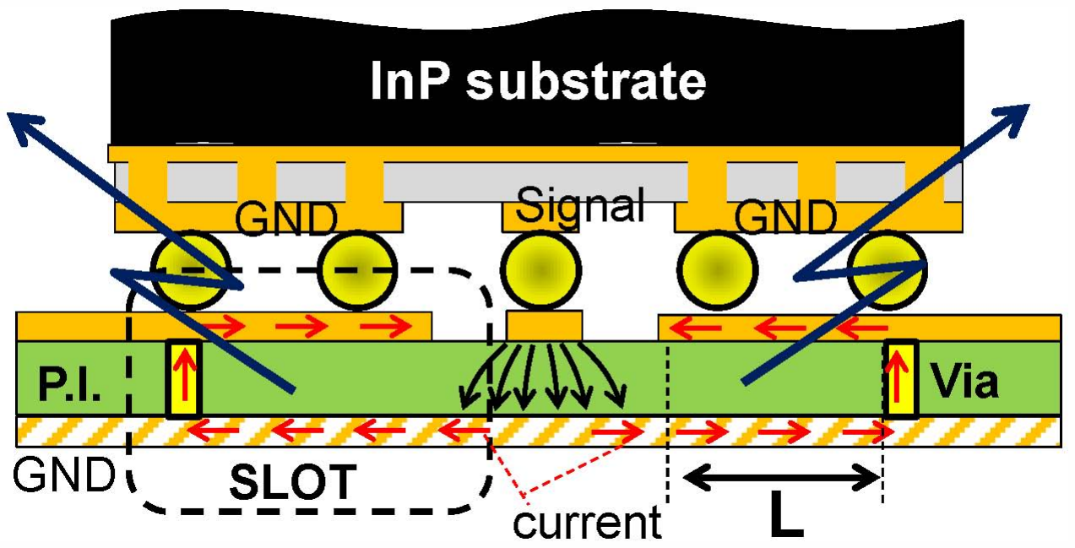
[picture p114: figure]

Fig2. a) Cross sectional view, and b) top view of substrate

The discontinuous GND connection between chip and substrate causes the signal radiation to the air. Fig.2a and 2b show the cross sectional view of the flip chip mounting and the top view of the substrate, respectively. As indicated with the dashed line, the slot is formed between the top GND and the bottom GND of the polyimide substrate. The radio signal whose wavelength is four times of the L between the edge of GND and the through vias, is radiated from the slot. The space

D between the two through vias also affects the loss of the substrate. Because the GND patterns on the top metal layer have some inductances, the large space of the vias makes the GND non-ideal. By using the electro-magnetic simulation, we calculated the impact of L and D on the loss.

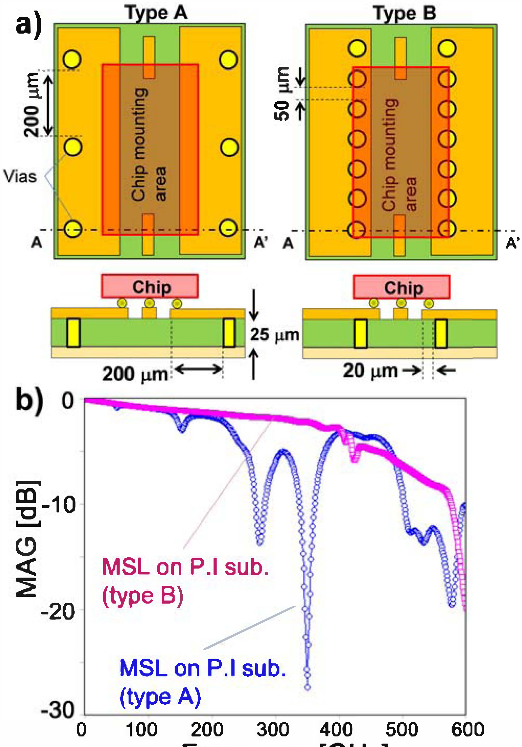
[picture p115: figure]
MSL on Pol sub. (type 8) /; MSL on P.I sub. (type A) -30

## Frequency [GHz]

Fig. 3a) Substrates of type A and B, and b) simulation results.

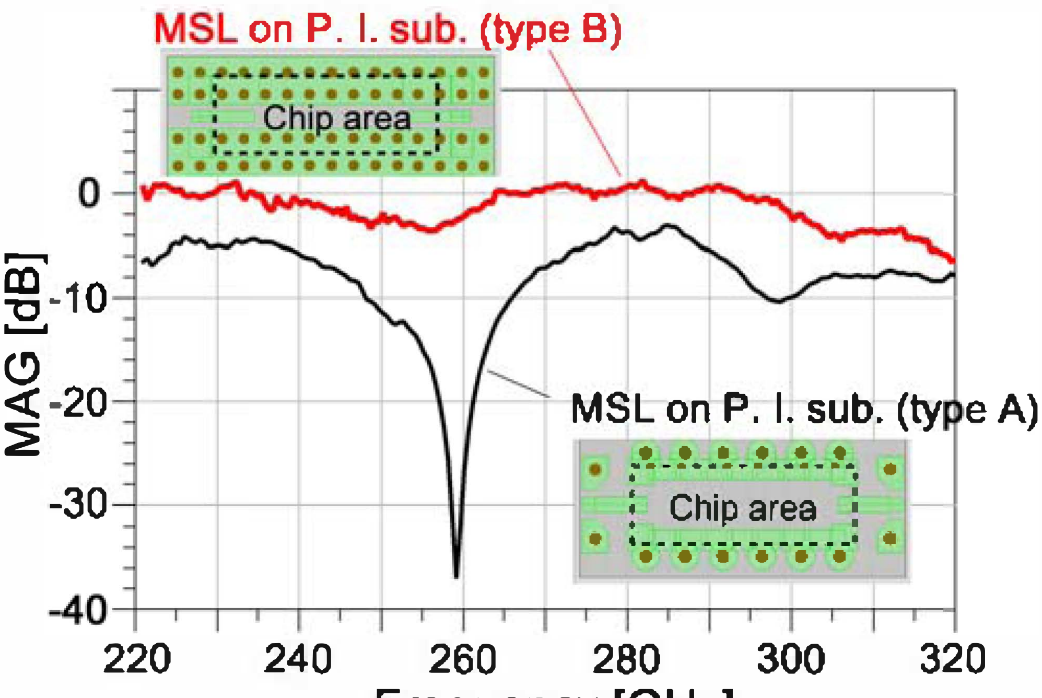
[picture p116: figure]
SL on P. I. su . (type B); : Chip area; too .. __ .... __ .. ___ .. .. I

| MSL on P. I. sub. (ty e A)

## Frequency [GHz]

Fig. 4 Measurement results.

978'1-4799-3869-8/14/$31.00 ®2014 IEEE

Authorized licensed use limited to: Eindhoven University of Technology. Downloaded on September 05,2024 at 10:14:06 UTC from IEEE Xplore. Restrictions apply.

Fig.3a shows the top and the cross-sectional views of the flip chip module used for the calculation. Fig.3b shows the simulated results. We compare two types of the substrate named type A and type B. The type A is the coarse pattern having Land D of 200 /--lm. On the other hand, the type B is the fine pattern designed using the minimum value of Land D in the design rule of the polyimide. In regard to those patterns, we calculated the maximum available gain (MAG) defined by the following equations;

MAG = IS211/lS121 {K_(Kz
_l)

l/z}
K = (1+1D1

2
-lSI li

z -ISzzl

z
) I (2ISlzS21)1
D = SllS22 - SIZS21

(1)
(2)
(3)

The thickness of the substrate is 25 /--lm, and the diameter of the ball bump is 50 /--lm. As shown in the graph, the MAG line of type A has the large dips around 300 GHz because of the slot mode radiation. Since the dip is same as the resistive loss, it cannot be eliminated by changing the impedance matching to the input and output nodes. On the other hand, type B has small insertion loss up to 400 GHz, and the dip exists in the line of type A is not observed.
Next, to confirm the simulated results, we fabricated the samples of the flip chip mounted MSL for both substrates of type A and B. The polyimide was used for the substrate. FigA shows the measured MAG of the fabricated samples. The MAG lines of the flip chip mounted MSL on type A (black line) and B (red line) are plotted in the figure. The flip chip mounted MSL on type A has quite large dip around 260 GHz. On the other hand, the MAG line of MSL on type B has almost flat characteristic in the broadband. Those results support the simulation and clearly indicate that it is required to minimize the size of L and D of substrate to achieve the performance of the module. Therefore, we chose the poly imide substrate for the flip chip mounting in the sub-millimeter wave band.

III. MEASUREMENT RESULTS OF MMIC
We developed the flip chip mounted MMIC and measured the RF performances. Fig.5a shows the circuit diagram of the amplifier MMIC comprised of the 6-stage common-source amplifiers [8]. The amplifier MMIC was fabricated in 75 nm InP HEMT technology with three Au metal layers and BCB thin films. Land D in the poly imide substrate were designed in the same manner we discussed in above section. Fig.5b and 5c show the photographs of the flip chip mounted MMIC and the cross-sectional view. The polyimide substrate is mounted on the metal plate with the conductive paste. The height of the ball bumps are about 40 /--lm. Fig.5d shows the measured S-parameters (SII, SZI, Szz). The dashed line is the result of the MMIC bare chip, and the solid line is that of the flip chip mounted MMIC. The gain was about 20 dB in the frequency range of 240 - 260 GHz, and frequency characteristics has not been changed. In our knowledge, this is the first result of the flip chip mounted MMIC in the sub-millimeter wave band.

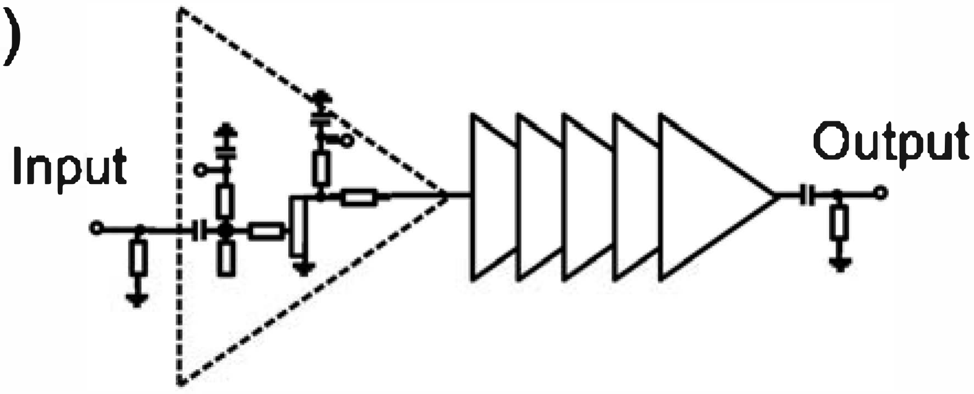
[picture p117: figure]
Output T Input

(a)

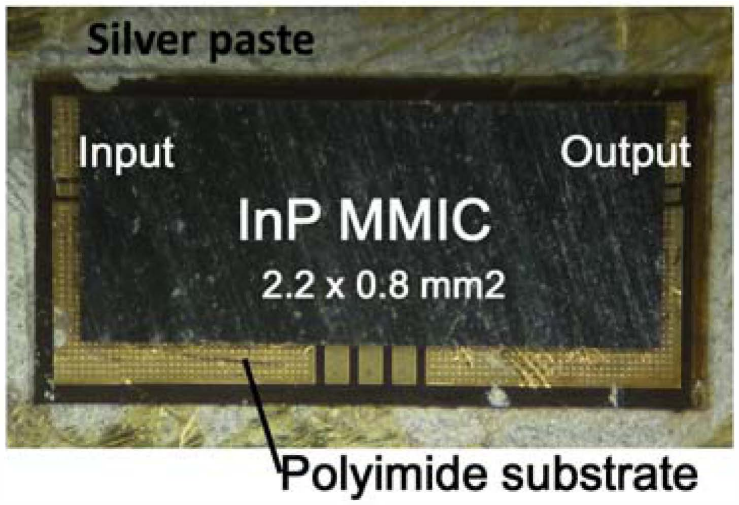
[picture p118: figure]

(b)

(c)

(d)

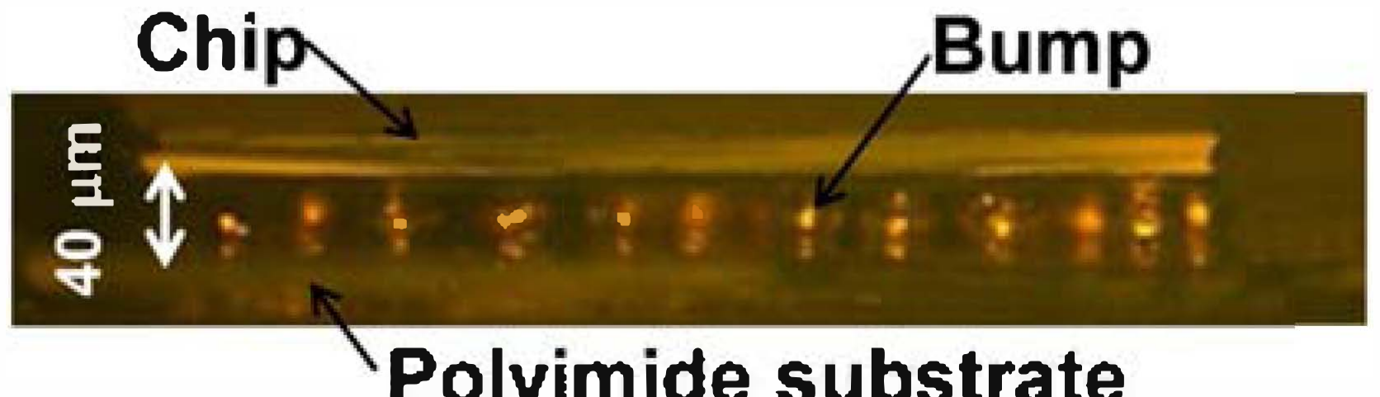
[picture p119: figure]

PolYlmlde substrate

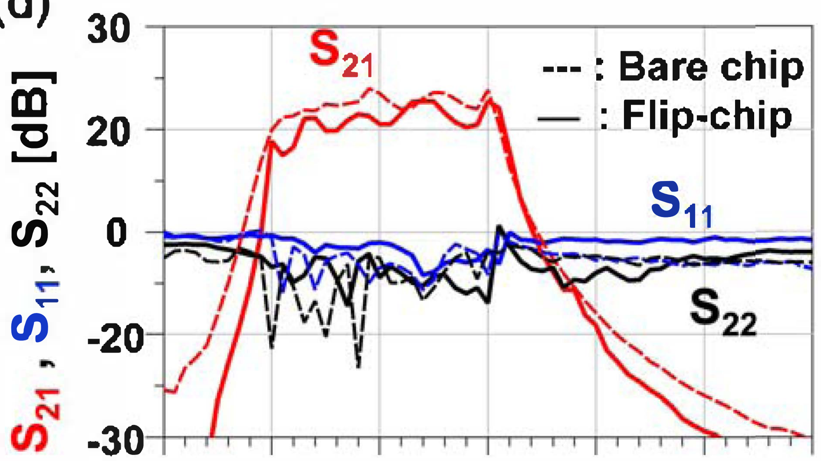
[picture p120: figure]
--- : Bare chip; : Flip-chip

230 240 250 260 270 280 290

## Frequency [GHz]

Fig.5 a) Circuit diagram of the 6-stage amplifier, b) photo of the flip chip mounted MMIC, c) cross-sectional view, and d) measured S-parameters.

Authorized licensed use limited to: Eindhoven University of Technology. Downloaded on September 05,2024 at 10:14:06 UTC from IEEE Xplore. Restrictions apply. 978·1-4799-3869-8/14/$31.00 ®2014 IEEE

IV. SUMMARY
The feasibility of the flip chip mounting on the polyimide substrate in the sub-millimeter wave band was described. It was demonstrated the distance between metal edge and through via (L) and the pitch of vias (D) were required to minimize in order to avoid the loss degradation. From view of the loss, the polyimide was the optimum substrate for the flip chip mounting in the sub-millimeter wave band. The flip chip mounted amplifier MMIC successfully demonstrated the gain of more than 20 dB in 230 - 260 GHz and frequency band characteristics without any shift by the chip mounting. Those results increase the possibility for sub-millimeter wave applications using the flip chip assembly.

Acknowledgement
The authors would like to thank the device processing group in Fujitsu Laboratories Ltd. This work was supported in part by the research and development program on Multi-tens gigabit wireless communication technology at subterahertz frequencies of the Ministry of Internal Affairs and Communications, Japan.

REFERENCES
[1] F. T. Ulaby, "Absorption in 220 GHz Atomospheric Window", IEEE Trans. on Antennas and Propagation, 1973.
[2] L. Samoska. et aI, "On-Wafer Measurements of S-MMIC Amplifiers {rom 400-500 GHz" Micro. Symp. Tech. Dig. IEEE MTT-s 2011.
[3] A. Tessmann et aI, "High-Gain Sub-millimeter-Wave mHEMT Amplifier MMICs" Micro. Symp. Tech. Dig. IEEE MTT-s 2010.
[4] T.B.Reed et al. "A I80mW InP HBT Power Amplifier MMIC at 214 GHz" IEEE Compo Semi. IC Symp. Tech. Dig. 2013.
[5] Z. Griffith et aI, "A 227.5 GHz InP HBT SSPA MMIC with 101 mW Pout at 14.0 dB Compressed Gain and 4.04% PA£,' IEEE Compo Semi. IC Symp. Tech. Dig. 2013.
[6] W. R. Deal, "InP HEMT Integrated Circuits for Sub-millimeter Wave Radiometers in Earth Remote Sensing",
Micro. Symp. Tech. Dig. IEEE MTT-s 2012.
[7] A. Tessmann et aI, "A Monolithic Integrated mHEMT Chipset for High-Resolution Sub-millimeter-Wave Radar Applications" IEEE Compo Semi. IC Symp. Tech. Dig. 2013.
[8] Y. Kawano et aI, "230-240 GHz, 30 dB Gain Amplifier in InP-HEMT for Multi-10Gb/s Data Communication System" IEEE Compo Semi. IC Symp. Tech. Dig. 2013.

978'1-4799-3869-8/14/$31.00 ®2014 IEEE

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
