danieltyukov/tue-bep/rf_die/coplanar_waveguide_simulation.png

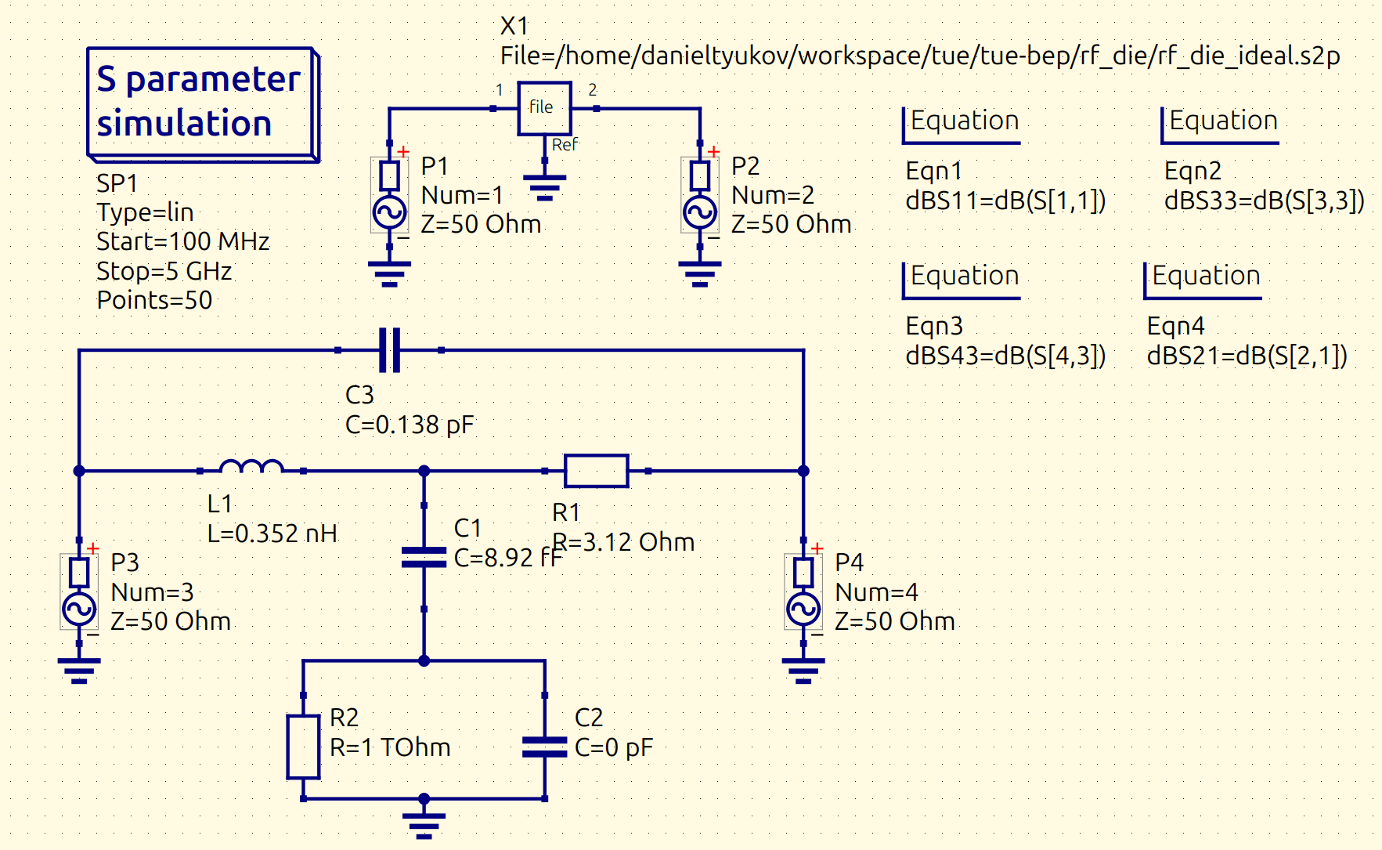
rf_die/coplanar_waveguide_simulation.png
