danieltyukov/tue-bep/final_paper_overleaf_template/1819283_Development_and_Characterization_of_a_Gold-Bump Flip-Chip_Bonding_Process_for_RF_IC_Applications/figures/tgf_2023_2_02_cw_test_model.pdf

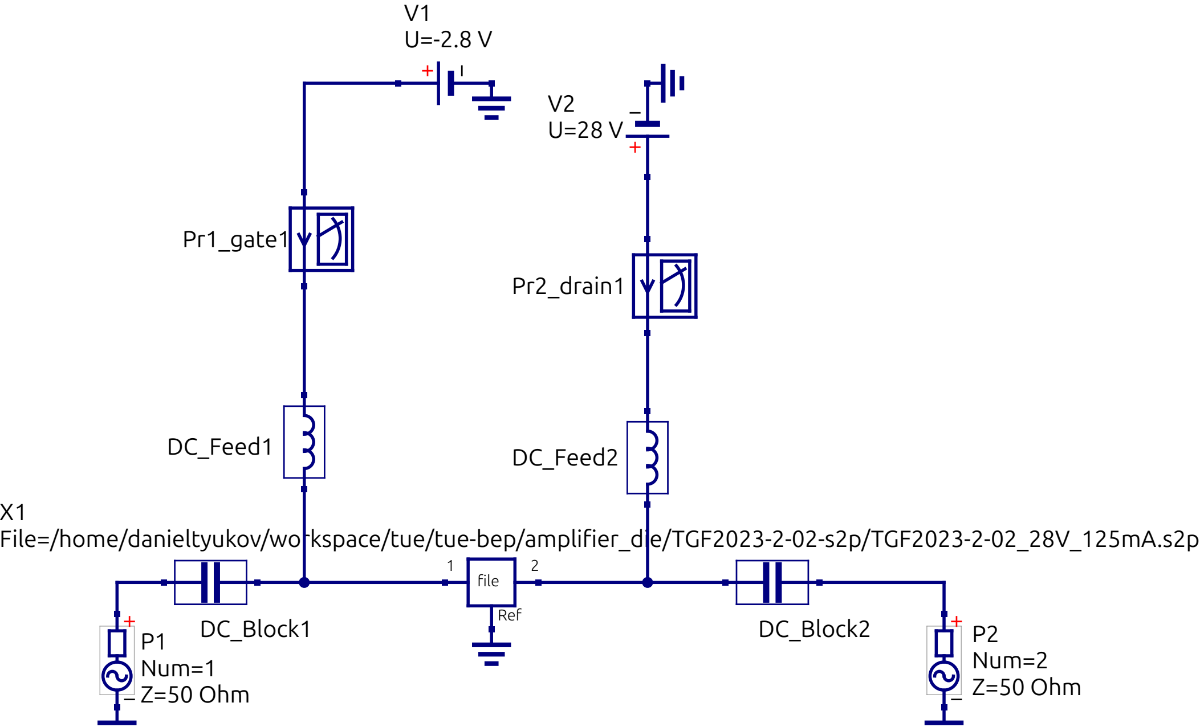
[picture p142: figure]
P1 Num=1 Z=50 Ohm; Pr2_drain1; P2 Num=2 Z=50 Ohm; Ref; X1 File=/home/danieltyukov/workspace/tue/tue-bep/ampli(er_die/TGF2023-2-02-s2p/TGF2023-2-02_28V_125mA.s2p; Pr1_gate1; DC_Feed1; DC_Feed2; DC_Block1; DC_Block2
