danieltyukov/tue-bep/final_paper_overleaf_template/1819283_Development_and_Characterization_of_a_Gold-Bump Flip-Chip_Bonding_Process_for_RF_IC_Applications/figures/rf_simulated_dut.pdf

G

S

G

_

P

r

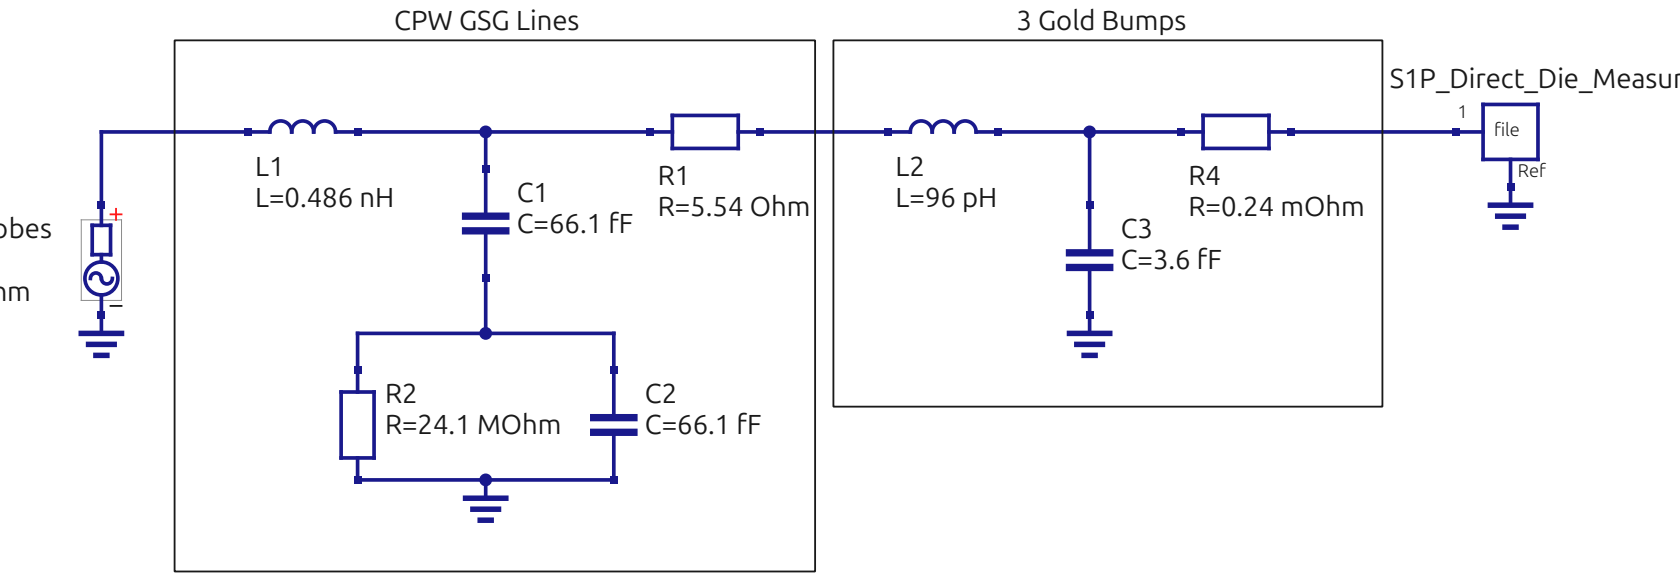
[picture p144: figure]
Dir; Die; Lin

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
