danieltyukov/tue-bep/final_paper_overleaf_template/1819283_Development_and_Characterization_of_a_Gold-Bump Flip-Chip_Bonding_Process_for_RF_IC_Applications/figures/interposer_flowchart2.pdf

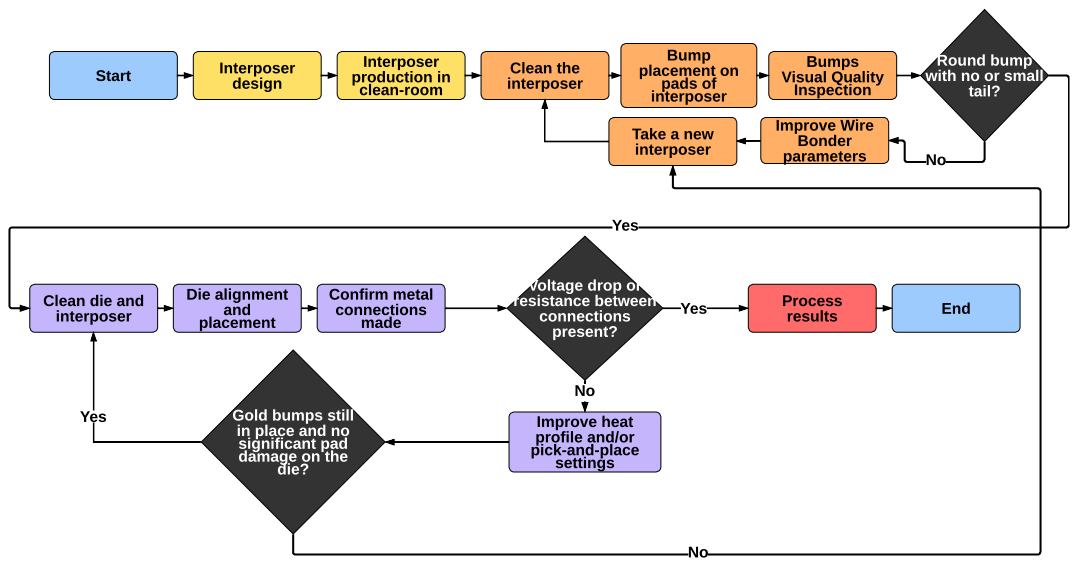
[picture p146: page 1]
Start; Interposer design; Interposer production in clean-room; Clean the interposer; Bump placement on pads of interposer; Bumps Visual Quality Inspection; Die alignment and placement; Confirm metal connections made; Process; results Yes; End; Yes; Improve Wire Bonder parameters; Take a new interposer

Round bump
with no or small
tail?

Voltage drop or
resistance between
connections
present?

Clean die and
interposer

Improve heat
profile and/or
pick-and-place
settings

Gold bumps still
in place and no
significant pad
damage on the
die?
