danieltyukov/tue-bep/final_paper_overleaf_template/1819283_Development_and_Characterization_of_a_Gold-Bump Flip-Chip_Bonding_Process_for_RF_IC_Applications/figures/wirebond.pdf

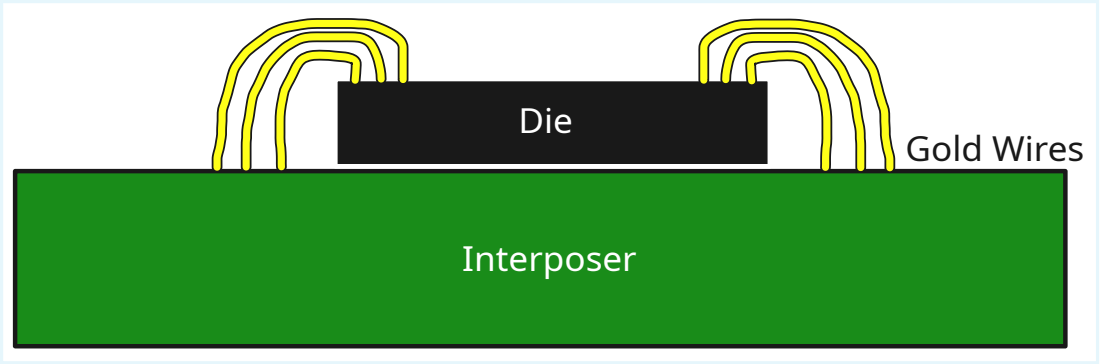
[picture p152: page 1]
Gold Wires; Interposer; Die
