danieltyukov/tue-bep/final_paper_overleaf_template/1819283_Development_and_Characterization_of_a_Gold-Bump Flip-Chip_Bonding_Process_for_RF_IC_Applications/figures/interposer_flowchart.pdf

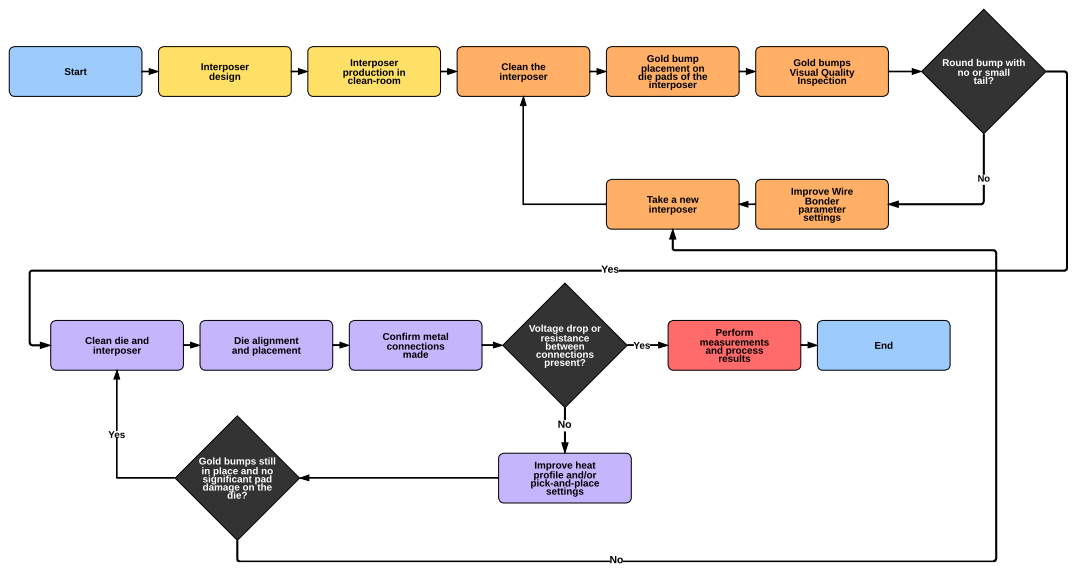
[picture p153: page 1]
Start; Interposer design; Interposer production in clean-room; Clean the interposer; Gold bumps Visual Quality Inspection; Die alignment and placement; Confirm metal connections made; Take a new interposer; Improve Wire Bonder parameter settings; Perform measurements and process results; Yes; End; Voltage drop or resistance between connections present?

Gold bump
placement on
die pads of the
interposer

Round bump with
no or small
tail?

Clean die and

Gold bumps still
in place and no
significant pad
damage on the
die?

Improve heat
profile and/or
pick-and-place
settings
