danieltyukov/tue-bep/final_paper_overleaf_template/1819283_Development_and_Characterization_of_a_Gold-Bump Flip-Chip_Bonding_Process_for_RF_IC_Applications/figures/magnitude_final.pdf

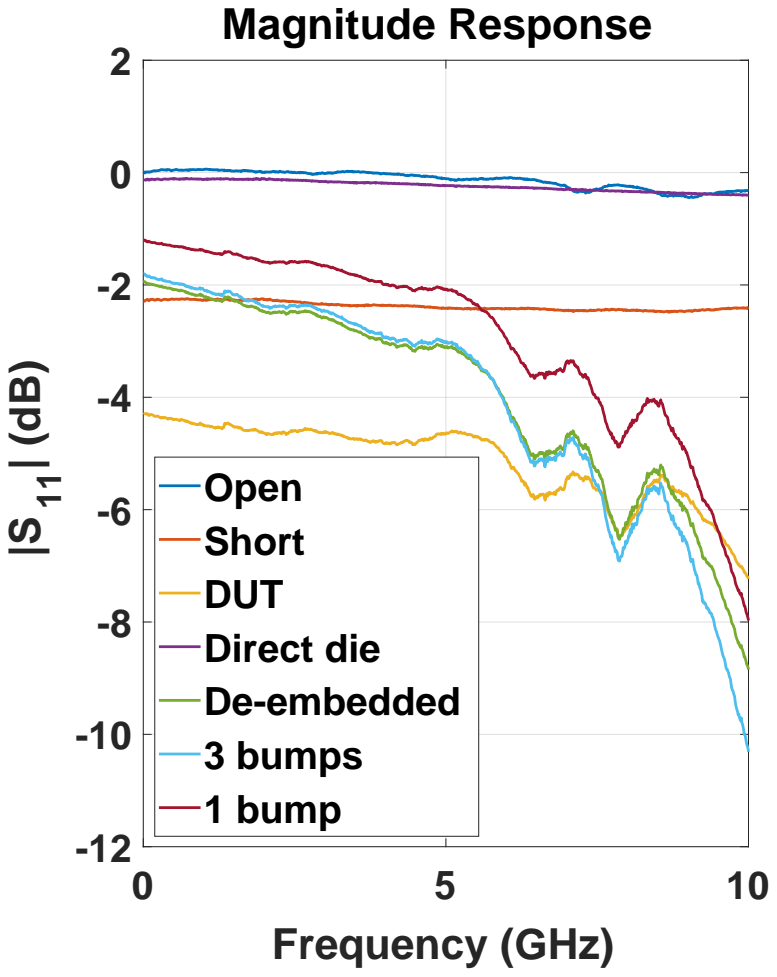
[picture p156: page 1]
Frequency (GHz); Magnitude Response

Open
Short DUT

Direct die De-embedded

3 bumps 1 bump
