danieltyukov/tue-bep/final_paper_overleaf_template/1819283_Development_and_Characterization_of_a_Gold-Bump Flip-Chip_Bonding_Process_for_RF_IC_Applications/figures/rf_simulated_vs_real_dut_cropped_magnitude2.pdf

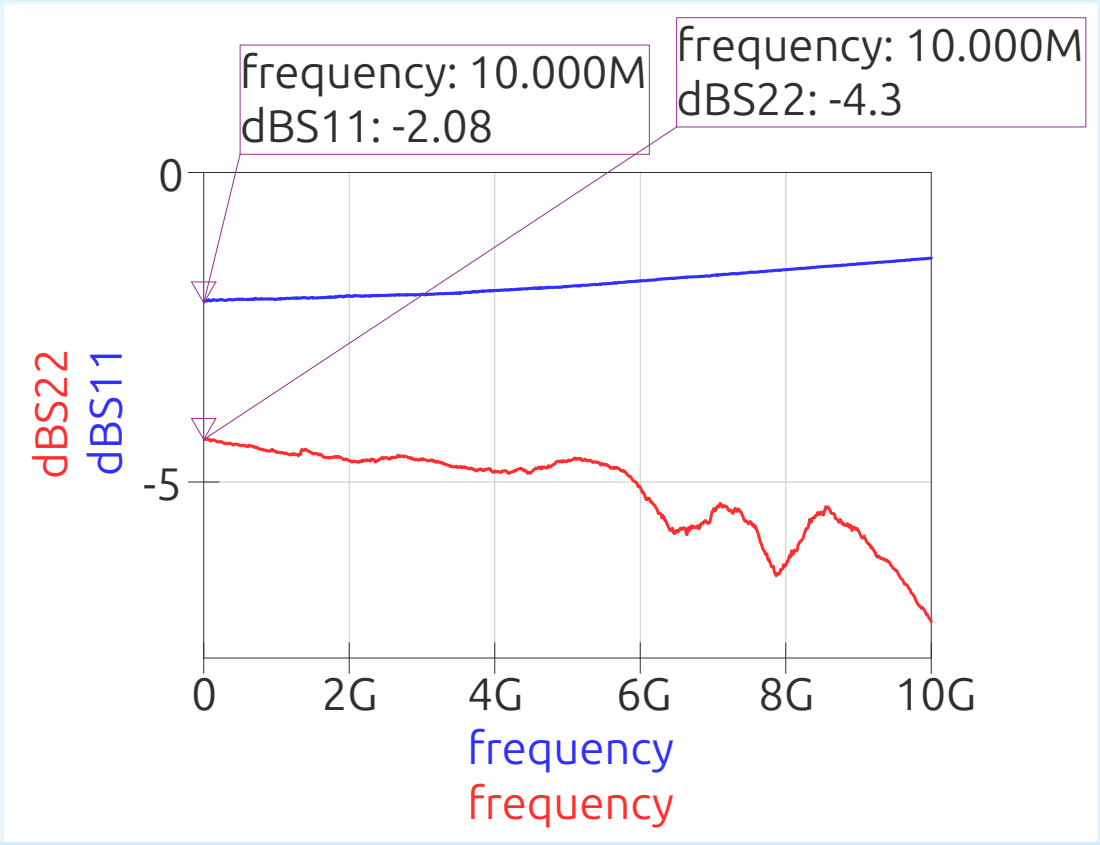
[picture p159: page 1]
frequency frequency; frequency: 10.000M dBS11: -2.08; frequency: 10.000M dBS22: -4.3
