danieltyukov/tue-bep/final_paper_overleaf_template/1819283_Development_and_Characterization_of_a_Gold-Bump Flip-Chip_Bonding_Process_for_RF_IC_Applications/figures/rf_simulated_vs_real_dut_cropped_smithchart2.pdf

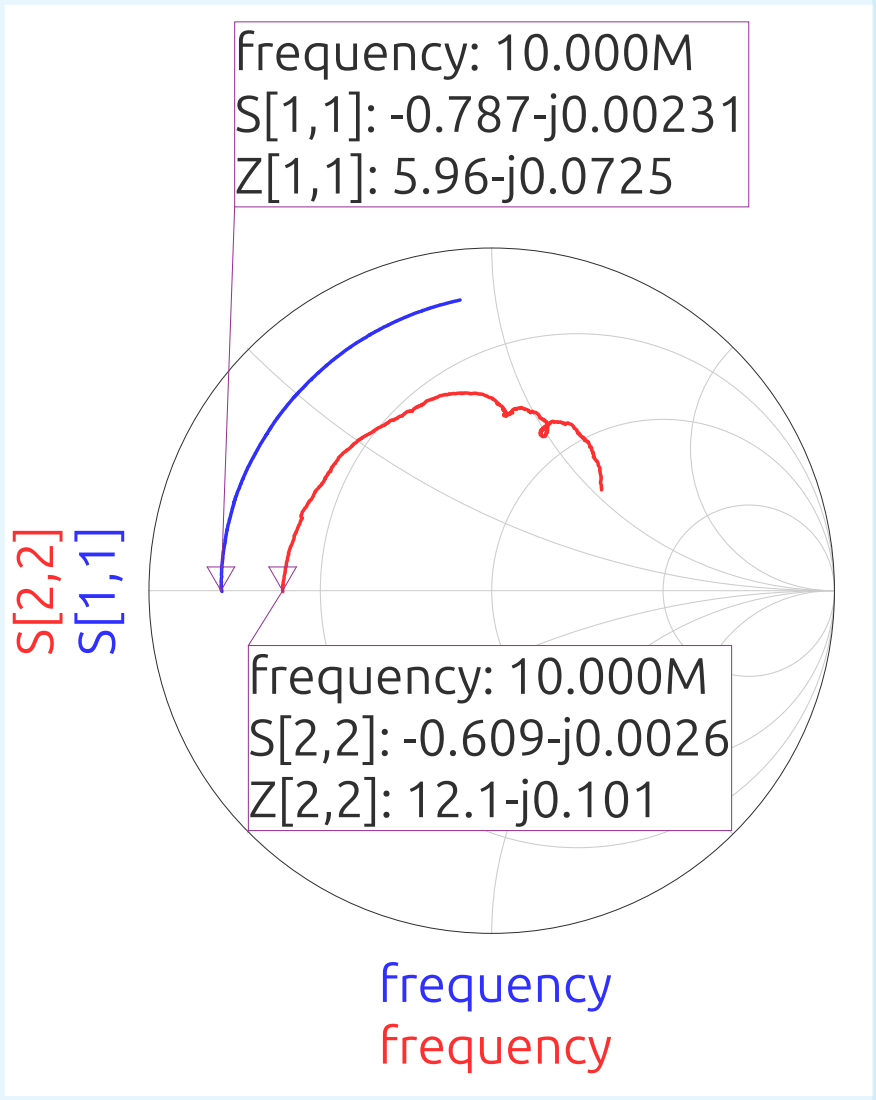
[picture p160: page 1]
frequency frequency; frequency: 10.000M S[1,1]: -0.787-j0.00231 Z[1,1]: 5.96-j0.0725; frequency: 10.000M S[2,2]: -0.609-j0.0026 Z[2,2]: 12.1-j0.101
