danieltyukov/tue-bep/final_paper_overleaf_template/1819283_Development_and_Characterization_of_a_Gold-Bump Flip-Chip_Bonding_Process_for_RF_IC_Applications/figures/tgf_2023_2_02_cw_model.pdf

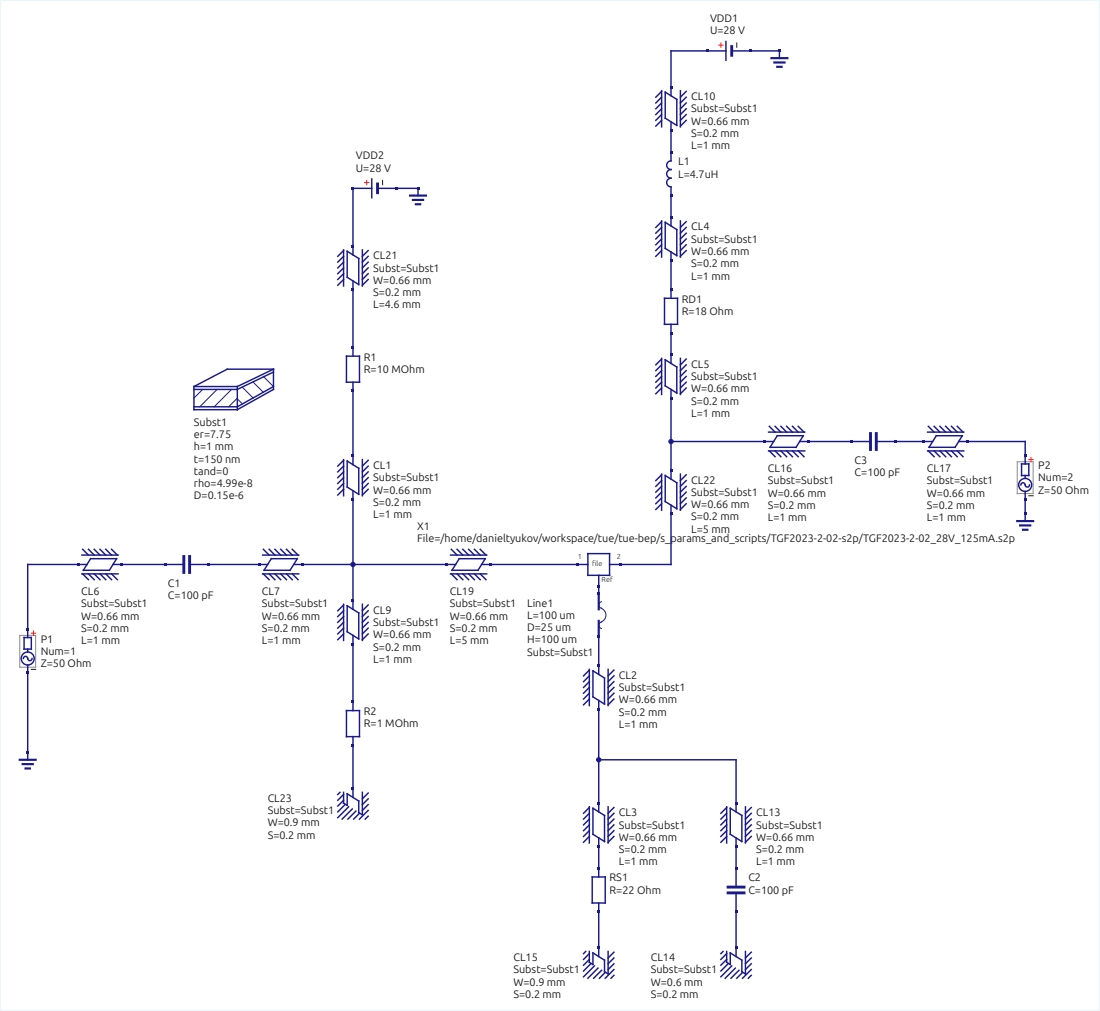
[picture p165: page 1]

File=/home/danieltyukov/workspace/tue/tue-bep/s_params_and_scripts/TGF2023-2-02-s2p/TGF2023-2-02_28V_125mA.s2p
