danieltyukov/tue-bep/final_paper_overleaf_template/1819283_Development_and_Characterization_of_a_Gold-Bump Flip-Chip_Bonding_Process_for_RF_IC_Applications/figures/tgf_2023_2_02_cw_model_g1.pdf

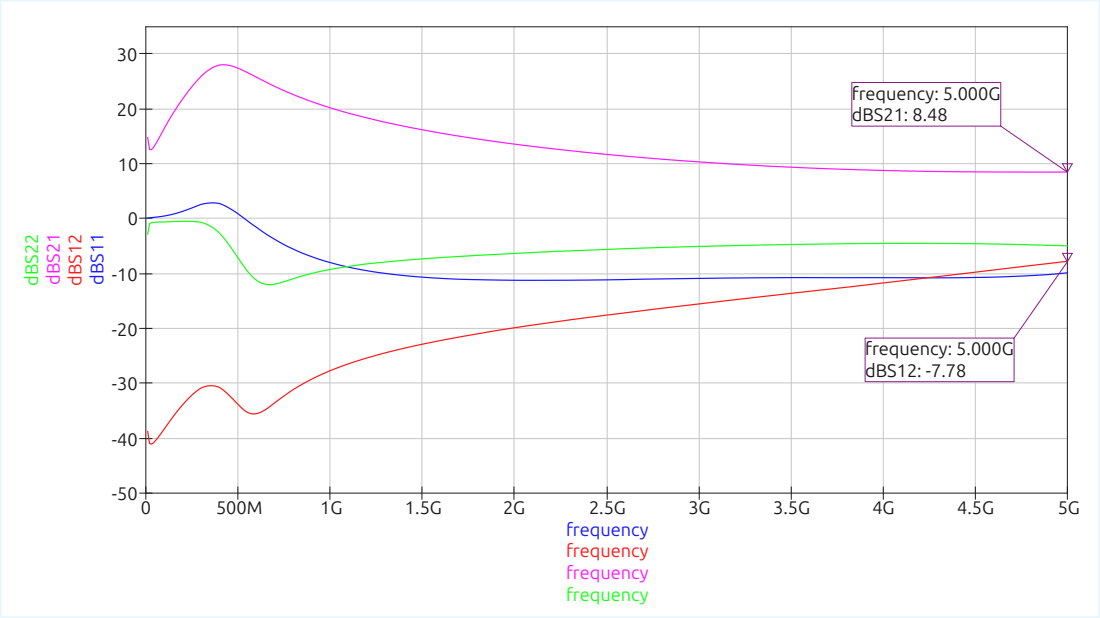
[picture p166: page 1]
dBS11; dBS12; dBS21; dBS22
