danieltyukov/tue-bep/final_paper_overleaf_template/1819283_Development_and_Characterization_of_a_Gold-Bump Flip-Chip_Bonding_Process_for_RF_IC_Applications/figures/tgf_2023_2_02_cw_model_g2.pdf

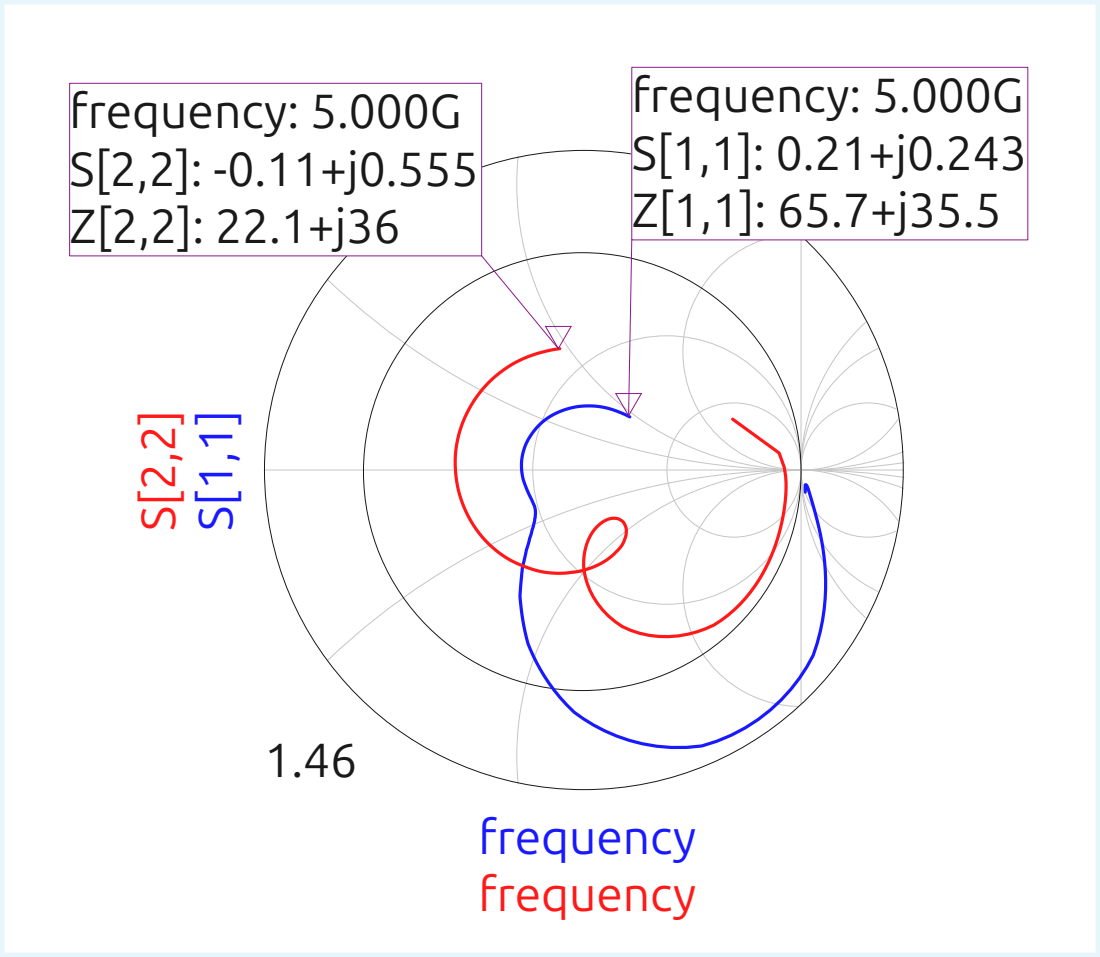
[picture p167: page 1]
frequency frequency; frequency: 5.000G S[1,1]: 0.21+j0.243 Z[1,1]: 65.7+j35.5; frequency: 5.000G S[2,2]: -0.11+j0.555 Z[2,2]: 22.1+j36
