danieltyukov/tue-bep/final_paper_overleaf_template/1819283_Development_and_Characterization_of_a_Gold-Bump Flip-Chip_Bonding_Process_for_RF_IC_Applications/figures/rf_simulated_vs_real_dut.pdf

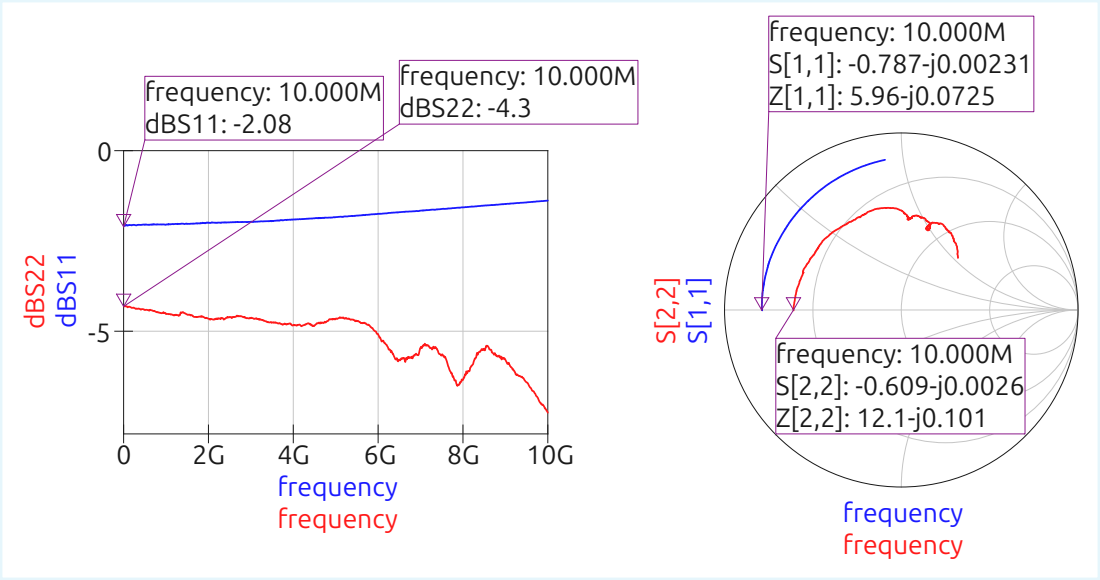
[picture p168: page 1]
dBS11; dBS22
