danieltyukov/tue-bep/final_paper_overleaf_template/1819283_Development_and_Characterization_of_a_Gold-Bump Flip-Chip_Bonding_Process_for_RF_IC_Applications/figures/tgf_2023_2_02_cw_test_model_g1.pdf

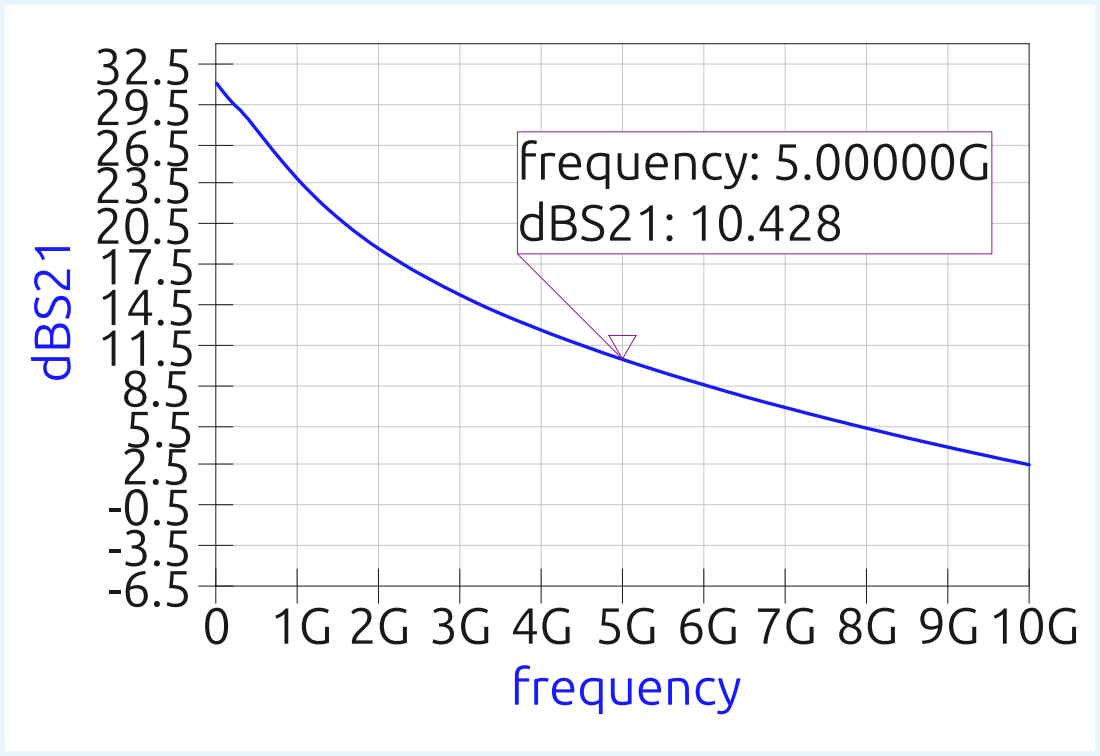
[picture p173: page 1]
frequency; frequency: 5.00000G dBS21: 10.428
