danieltyukov/tue-bep/final_paper_overleaf_template/1819283_Development_and_Characterization_of_a_Gold-Bump Flip-Chip_Bonding_Process_for_RF_IC_Applications/figures/tgf_2023_2_02_cw_test_model_g2.pdf

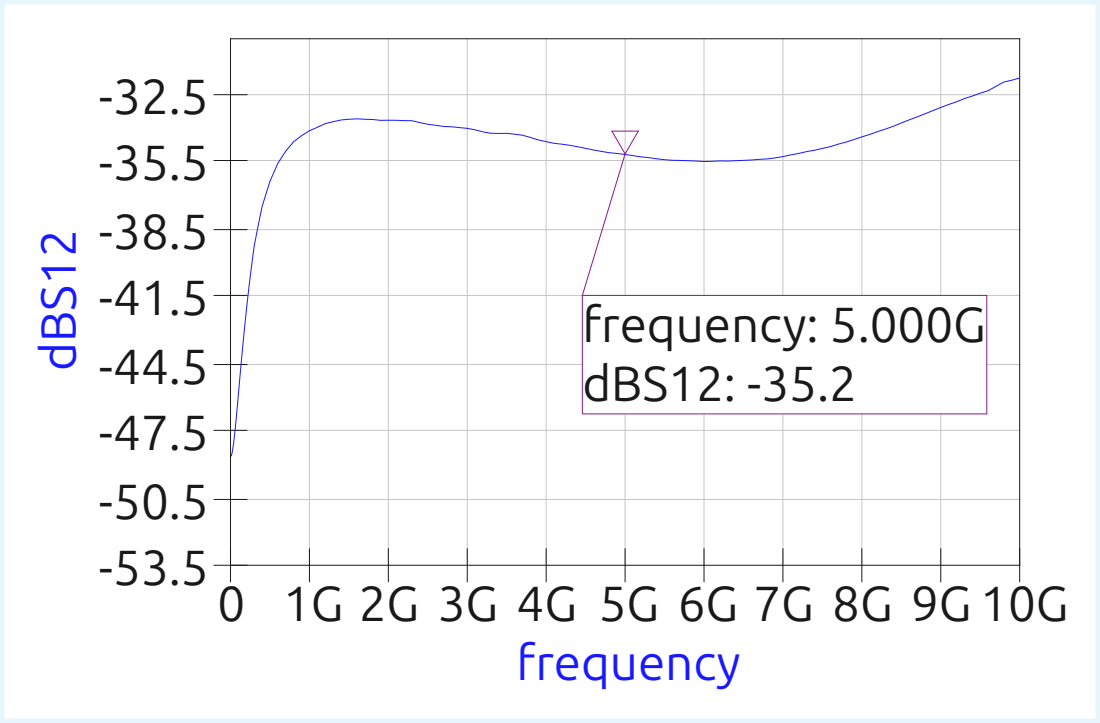
[picture p174: page 1]
frequency; frequency: 5.000G dBS12: -35.2
