danieltyukov/tue-bep/final_paper_overleaf_template/1819283_Development_and_Characterization_of_a_Gold-Bump Flip-Chip_Bonding_Process_for_RF_IC_Applications/figures/tgf_2023_2_02_cw_test_model_g3.pdf

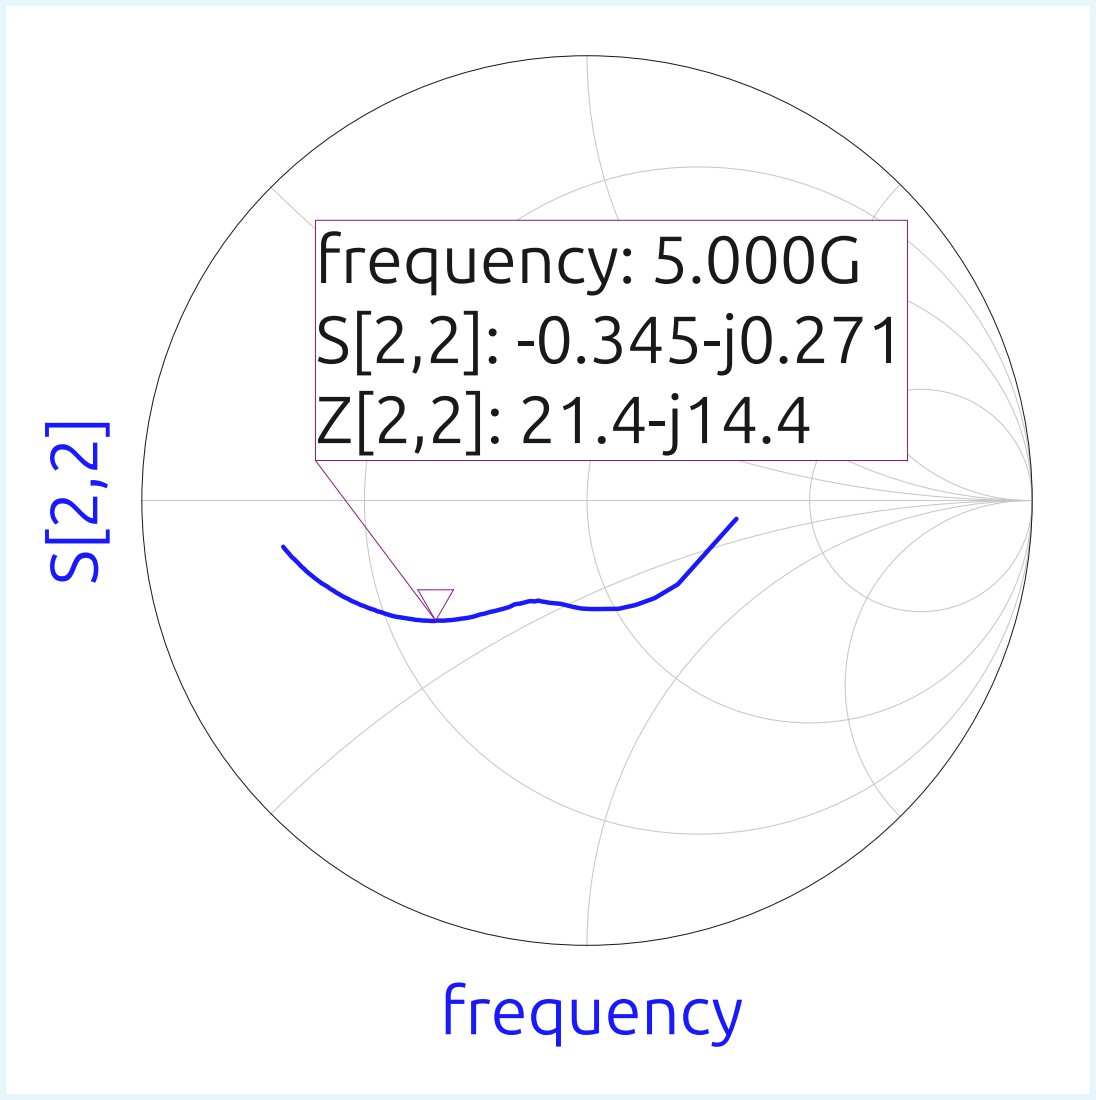
[picture p175: page 1]
frequency; frequency: 5.000G S[2,2]: -0.345-j0.271 Z[2,2]: 21.4-j14.4
