danieltyukov/tue-bep/(commit log)

2025-04-13 Add High Frequency PA Die Comparison Excel file
    - Introduced a new Excel file containing detailed comparisons of high frequency power amplifier dies.
    - The file includes various metrics and specifications relevant to performance evaluation.
    [High_Frequency_PA_Die_Comparison.xlsx]
2025-04-19 Add TXFE interposer GDS file with circle and octagon pad definitions
    - Introduced a new GDS file for the TXFE interposer design.
    - Defined multiple circle and octagon pads with specified parameters.
    - Included layer information for Au and Ti materials.
2025-04-21 Add ideal S-parameter data for RF die in rf_die_ideal.s2p
    [cpw_glass_1mm.sch]
2025-04-21 adding new datasheets
    [High_Frequency_PA_Die_Comparison.xlsx]
2025-04-22 Add GaN HEMT Die Comparison spreadsheet with detailed data and analysis
    [GaN_HEMT_Die_Comparison (1).xlsx]
2025-04-28 Update GDS and image files for RF die design: replace and add new pad and trace images
2025-04-28 Add new GDS file and multiple pad and trace images for RF die design
2025-04-28 Add new GDS file and multiple unrealistic pad images for RF die design
2025-04-28 Add new realistic and unrealistic pad and trace images for RF die design
2025-04-28 Update TXFE interposer GDS file for RF die design
2025-04-29 Update TXFE interposer GDS file and add traces image for RF die design
2025-04-29 Remove outdated CPW schematic and update TXFE interposer GDS file; add new unrealistic pad and trace images for RF die design
    [cpw_glass_1mm.sch]
2025-05-04 Add RF amplifier design files and datasheets
    - Created a new LT-Spice netlist for the TGF2023 RF amplifier, detailing the circuit configuration and components used.
    - Added a comparison Excel sheet for GaN HEMT dies to the datasheets directory.
    - Included a ZIP file containing additional datasheets relevant to the project.
    - Added a PDF document related to the amplifier design.
    - Introduced a Qucs schematic file for the RF amplifier, outlining the circuit layout and component values.
    [GaN_HEMT_Die_Comparison.xlsx, rf.sch]
2025-05-04 Add amplifier simulation files and research papers
    - Created a new Qucs schematic file for the amplifier simulation (tgf2023_2_02_amplifier_cs.sch) including components, wires, and equations.
    - Added a corresponding Qucs display file (tgf2023_2_02_amplifier_cs.dpl) for visual representation of the simulation results.
    - Included two research papers on ultra-wideband power amplifiers based on GaN HEMT technology in PDF format.
    [circuit_model_of_CPW_structure_v1.sch, tgf2023_2_02_amplifier_cs.sch]
2025-05-04 Remove outdated RF die layout and related files
2025-05-04 Add ideal RF die S-parameter file
2025-05-05 Remove obsolete amplifier simulation files: tgf2023_2_02_amplifier_cs.dpl and tgf2023_2_02_amplifier_cs.sch
    [circuit_model_of_CPW_structure_v1.sch, tgf2023_2_02_amplifier_cs.sch]
2025-05-08 Add new schematic and display files for TGF simulation
    - Created `tgf_without_lines.dpl` for display properties and diagram representation.
    - Created `tgf_without_lines.sch` for the schematic layout including components and connections.
    - Updated `TXFE_interposer.gds` with binary changes.
    [circuit_model_of_CPW_structure_v1.sch, tgf2023_2_02_FINAL_CW.sch, tgf2023_2_02_analysis.sch, tgf2023_2_02_common_source_amplifier.sch, tgf2023_2_02_cw_cs.sch, tgf_without_lines.sch]
2025-06-01 Remove obsolete schematic and display files for tgf_without_lines
    [circuit_model_of_CPW_structure_v1.sch, tgf2023_2_02_FINAL_CW.sch, tgf2023_2_02_analysis.sch, tgf2023_2_02_common_source_amplifier.sch, tgf2023_2_02_cw_cs.sch, tgf_without_lines.sch]
2025-06-05 Refactor code structure for improved readability and maintainability
    [GaN_HEMT_Die_Comparison.xlsx, rf.sch]
2025-06-07 Refactor de-embedding script for improved structure and clarity; streamline loading and processing of S-parameter files
2025-06-07 Refactor de-embedding script to enhance clarity and structure; improve plotting for S-parameter analysis
2025-06-07 Add new images for final paper: VNA machine setup, die, flip chipped die, flip chipped fake die, flip chipping fake die, interposer gold bumped, interposer probed, and yield interposer
2025-06-07 Add yield die image for final paper
2025-06-07 Add new de-embedding plots and scripts for analysis
2025-06-08 added final qucs simulation files
    [rf_FINAL_CW.sch, tgf2023_2_02_FINAL_CW.sch, tgf2023_2_02_analysis.sch]
2025-06-08 Remove obsolete schematic file and add new simulation result PDFs for comparison of simulated and real DUT performance.
    [rf_FINAL_CW.sch, tgf2023_2_02_FINAL_CW.sch, tgf2023_2_02_analysis.sch]
2025-06-08 Add Qucs schematic for TGF2023-2-02 analysis
    - Created a new schematic file 'tgf2023_2_02_analysis.sch' for the TGF2023-2-02 project.
    - Included components such as voltage sources, DC feeds, and probes.
    - Defined equations for S-parameters and set up DC and SP analysis configurations.
    - Established wiring connections between components for simulation purposes.
    [rf_FINAL_CW.sch, tgf2023_2_02_FINAL_CW.sch, tgf2023_2_02_analysis.sch]
2025-06-08 Add labeled GSG probe image and interposer flowchart PDF for paper
2025-06-13 Add new schematic for TGF2023-2-02 analysis in Qucs format
    [rf_FINAL_CW.sch, tgf2023_2_02_FINAL_CW.sch, tgf2023_2_02_analysis.sch]
2025-06-19 Update QUCS circuit model image and add new RF simulation circuit diagram
2025-09-16 Add initial schematic for TGF2023-2-02 analysis in Qucs
    - Created a new schematic file `tgf2023_2_02_analysis.sch`
    - Included components such as Pac, GND, Vdc, IProbe, DCFeed, and DCBlock
    - Defined equations for S-parameters and set up DC and SP analysis
    - Configured a reference S-parameter file for simulation
    [rf_FINAL_CW.sch, tgf2023_2_02_FINAL_CW.sch, tgf2023_2_02_analysis.sch]
